sephiroth74/esp32-rc-telemetry/ROADMAP.md

# Firmware roadmap — step by step

The phase summary lives in [PLAN-ESP32.md](PLAN-ESP32.md) §8; this file breaks every phase into
steps. Section numbers (§) refer to PLAN-ESP32.md.

Every step is small, self-contained and testable, and none is done until:

- `make build` compiles and `make test` is green;
- a measurement it produced is in [docs/hardware.md](docs/hardware.md), and a decision it changed is
  in the plan.

**Order.** What has to be seen working first comes first: navigating the menu (Phase 2), then the
card and GNSS checks of the power-on self-test (Phase 3). Everything after builds on those two.

**Input hardware.** The steps assume the **two-button interim layout** of §3.1 — OK and NAV on the
D0 ladder. Fitting the JS5208 five-way switch is a separate procedure, possible at any point after
step 2.3: see [Switching to the JS5208](#switching-to-the-js5208).

`[x]` done · `[ ]` to do.

## Phase 0 — Bench tools (done)

- [x] **0.1 Display, card and button.** `tools/oled-sd-test`: OLED at 0x3C, SDMMC 1-bit at 40 MHz,
  FAT32 and long names, a 256 KB speed test, a restart button, a GPS page.
- [x] **0.2 GNSS link.** `tools/gps-test` on the shared `tools/lib/gm10`: GM10 found at 115200,
  NMEA and UBX, MON-VER answered.
- [x] **0.3 Results recorded.** Bench session 1 in `docs/hardware.md`.

## Phase 1 — Hardware bring-up and pin-map freeze

- [x] **1.1 Two-button ladder.** Fit the external 10 kΩ pull-up on D0, keep OK straight to GND, and
  add NAV through 10 kΩ. A small sketch, `tools/keys-test`, prints the ADC reading in mV for every
  key and shows the classified key on the OLED.
  *Done when:* the readings for OK, NAV and no key are in `docs/hardware.md`, and `KEY_MV_BOUNDS` in
  `config.h` is derived from them.
  *Result:* OK 0 mV, NAV 1,623 mV, no key 3,120 mV — the ADC saturates there — with no phantom
  presses; the RIGHT/none bound moved to 2,695 mV.
- [x] **1.2 Which GPIO is DAT3** (§2.2). Hold the candidate GPIO low while calling
  `SD_MMC.begin()`. A card that sees DAT3 low at CMD0 enters SPI mode, so the SD-mode init fails:
  failing with GPIO21 low means DAT3 is 21, failing with GPIO3 low means it is 3.
  *Done when:* the answer is in `docs/hardware.md`, and `PIN_SD_D3` and `PIN_RC_THROTTLE` are final
  in `pins.h` — throttle moves to D1 if DAT3 is GPIO3.
  *Result:* **GPIO21**, with `tools/sd-dat3-test`: one candidate low per power-up, since a card
  picks its mode once and ignores DAT3 after that. GPIO3 low mounted, GPIO21 low failed. Throttle
  stays on D2, and D1 stays spare.
- [ ] **1.3 GM10 supply** (§9 question 16). Check the module's input range. If it accepts 3.3 V,
  power it from 3V3 and repeat the `tools/gps-test` link check.
  *Done when:* the answer is in `docs/hardware.md`, and §2.7 says which rail powers the GM10.
- [ ] **1.4 GM10 magnetometer** (§9 question 4, first half). If the module has SDA/SCL pads, first
  check that they idle at 3.3 V and not 5 V, then wire them to D4/D5 and read the I²C scan of
  `tools/oled-sd-test`. The config-flash half needs VALSET: step 4.1.
  *Done when:* answered in `docs/hardware.md`.
- [x] **1.5 What the receiver sends** (§2.5). `tools/rc-scope` reads one channel's signal wire on D3
  through a 10 kΩ/10 kΩ divider, with the ADC as a scope, and plots it in the Arduino IDE's Serial
  Plotter: width, period and level per frame, or the waveform. Only the signal and ground are wired;
  the XIAO runs from USB.
  *Done when:* the logic level, the frame period and the steering and throttle widths of each car on
  the bench are in the per-car table of `docs/hardware.md`, inside the `RC_*` windows of `config.h`
  or with those windows changed.
  *Result:* the Inferno's KR-331 — 3.3 V logic, positive pulses every 16.6 ms (60 Hz), steering
  1,050–1,500–1,940 µs, throttle 1,005–1,500–≈1,940 µs, no telemetry on the throttle wire: all inside
  the `RC_*` windows, which stay as they are. Repeat for each new car.
- [x] **1.6 Freeze the pin map.**
  *Done when:* `pins.h` holds no `UNRESOLVED`, and the wiring section of `docs/hardware.md` describes
  the bench build.
  *Result:* DAT3 was the last open pin (step 1.2). The bench build and the car are KiCad schematics
  in `hardware/`, with the nets of `pins.h`, checked by the ERC and net by net.

## Phase 2 — Keys, display and menu navigation (first priority)

Goal: every screen of §3.4 reached and left with the two buttons, on placeholder data. The logic
lives in `lib/ui`, free of `Arduino.h` and host-tested (§6.1); `src/` only adapts the hardware.

- [x] **2.1 Key windows.** `lib/ui`: classify a reading in mV as OK, UP, DOWN, LEFT, RIGHT or no
  key against `KEY_MV_BOUNDS`. A key counts after `KEY_CONFIRM_SAMPLES` equal readings; a reading
  outside every window is discarded.
  *Test:* host tests on synthetic sample streams — clean presses, bounces, two keys at once.
- [x] **2.2 Gestures and layouts.** `lib/ui`: turn the key stream into events — short, long (firing
  at 1.5 s, with the hold-bar progress from 300 ms), auto-repeat for UP/DOWN — and apply the
  two-button mapping: NAV short is DOWN, NAV held 1 s is LEFT. This mapping is the only
  layout-specific code.
  *Test:* host tests for each layout, at the edges of every threshold (799/800 ms, 1499/1500 ms).
  *Result:* `lib/ui/ui_keys.{h,cpp}`, fed from `config.h` through `include/key_config.h`; 20 host tests
  in `test/test_ui`, against the measured ladder levels, including the millisecond counter wrapping.
- [x] **2.3 Keys on the device.** `src/keys.cpp`: ADC1_CH0, read in one-shot mode with the
  calibration curve so the result is in mV, at 100 Hz in the `ui` task. The events of 2.2 go to a
  queue.
  *Test:* on the bench, every press logged on the serial console as the right event.
  *Result:* `src/keys.cpp` and the `ui` task (`src/ui_fsm.cpp`), with `analogReadMilliVolts()` —
  the call the levels were measured with. On the bench every gesture gave its event at the exact
  threshold: NAV back at 1,000 ms, OK hold at 1,500 ms while still held, nothing for OK released at
  1,380 ms; readings OK 0 mV, NAV 1,613–1,628 mV, no key 3,121 mV.
- [x] **2.4 Display driver.** `src/display.cpp`: U8g2 on the hardware I²C at 400 kHz behind the bus
  mutex. Primitives for the status bar, the six body lines, the toast and the hold bar. Only dirty
  pages are sent (`updateDisplayArea`), at most at 5 Hz.
  *Test:* a test screen on the bench. Time a full-frame and a one-page update and record both in
  `docs/hardware.md`: they check the bus budget of §2.4.
  *Result:* `src/display.cpp` and the bus lock `src/i2c_bus.cpp`. Full frame 31.3 ms, one page
  3.9 ms — a little above the plan's estimate, same conclusion. On the bench the toast, the hold
  bar and the 80 ms inversion behave as §3.1–§3.2 say. A missing display is skipped in the code
  (headless boot), but that path is first tested in step 3.2.
- [x] **2.5 Menu model.** `lib/ui`: the menu tree of §3.4 as data — Home, Menu, submenus, dialogs
  (hold OK = yes, any other key or 10 s = no), list and value editors — with the cursor,
  wrap-around, back, and the 30 s fall-back to Home.
  *Test:* host tests that walk paths: Home → OK → Menu → … → Settings › Display → change → OK;
  dialogs answered both ways; both timeouts.
  *Result:* `lib/ui/ui_menu.{h,cpp}` — the lists as data, editors opening on the value in force, the
  refusals of §3.4 (no card, no fix, logging refused, no RC signal), and the two confirmation
  dialogs reachable from the menu. What an entry does comes out as a `Command` for the caller; the
  facts go in through `MenuContext`. 21 host tests in `test/test_menu`.
- [x] **2.6 Screens on placeholder data.** Render every screen of §3.4 from the model, with fixed
  sample data for GNSS, card, track and laps. SESSION, GEOMETRY, CALIBRATION and TRANSFER are stub
  states, entered and left as §3.7 says.
  *Test:* on the bench, every screen reached and left with the two buttons; every text within 21
  columns; the key hints in the two-button wording.
  *Result:* `lib/ui/ui_board` (the modes, their dialogs and toasts) and `lib/ui/ui_screens` (a pure
  render), with 16 host tests in `test/test_board` — one renders every screen and mode in both
  layouts and both text sizes and proves each line fits. On the bench the 5x8 text proved too small:
  `tools/font-test` compared seven fonts, the **6x13B** won, and text size became a setting of its
  own, small or large, with large the default and content that scrolls (§3.2).
- [x] **2.7 The on-device settings, for real.** Display brightness, dim delay and text size applied to
  the panel; the car profile selection stored. Kept in NVS for now — they move into `config.json` in
  step 3.6.
  *Test:* all of them survive a reset.
  *Result:* `src/settings` keeps brightness, dim delay, text size, the profile count and the active
  profile in NVS, checked against their ranges when read back, and writes only what a command
  changed. Brightness is the SSD1306 contrast (16, 96, 255), dimmed is 0. On the bench, low, 15 s,
  small and a New car came back after a reset as `settings: brightness low, dim after 15 s, text
  small, profile 4 of 4`. The bench also asked for the press that brightens a dimmed display to do
  nothing else: `Gestures::swallow()` now drops what the gesture has queued too, host-tested, and
  checked on the bench with OK, OK held and NAV on a dimmed display.
- [x] **2.8 New car and New track** (§3.4, §3.8, §7.1). New car is the choice after the profiles in
  Settings › Car profile; New track an entry of Track, held to create. Both work for any car or
  track that was not set up from a computer, and the apps rename them.
  *Result:* in `lib/ui` with their refusals — no card, no fix, `Full: 8 profiles` — and New car
  landing on Calibrate. Every screen is now tested with the longest track id, `N4512E00934-99`, which
  moved the start-line dialog onto new lines. The placeholder facts carry both out on the bench.

- [x] **2.9 Restart from the menu** (§3.4). Settings › Restart, held: the toast, then a restart and
  the POST. Asked on the bench in place of a key gesture, which the ladder cannot make safe.
  *Result:* works on the bench.

*Phase done when:* a walk through all of §3.4 on the bench, with the two buttons only.

## Phase 3 — Power-on self-test: card and GNSS link (first priority)

- [x] **3.1 POST runner.** The ordered checks of §3.3, one line per check on the POST screen, the
  result bitmask, the fatal latch with the hold-OK retry, the 3 s list of degraded checks, then
  IDLE. The keys are dead throughout. Ordering and severity logic in `lib/ui`.
  *Test:* host tests with fake checks — pass, degraded, fatal, fatal then passing on retry.
  *Result:* `lib/ui/ui_post` — the eleven checks with their severities, the run, the latch and its
  retry, the list worst first, the bitmask and the summary for About — and `renderPost` for its
  screens; 11 host tests in `test/test_post`, every screen within 21 columns at both sizes. On the
  device `src/post` runs it from `setup()` before the ui task, and swallows a key still held at the
  end. Check 0 is the display; the others report `--` until their steps. It reaches Home in 0.8 s.
- [x] **3.2 Checks 0–2.**
  - Display: I²C bus recovery, address ACK, init. A missing display boots headless.
  - PSRAM: the 256 KB ring buffer allocated.
  - LittleFS: mounted with the `littlefs` label (§6.3).

  *Test:* on the bench, with the display unplugged the board still boots, and the serial console
  shows the result.
  *Result:* `i2cBusBegin()` clocks a held SDA free before Wire starts, `log_ring` takes the 256 KB in
  PSRAM once, and LittleFS mounts by its `littlefs` label, formatting a blank partition on the first
  boot. On the bench: `0 Display ok`, `1 PSRAM ok 8MB`, `2 Config ok 8K used`, Home at 0.8 s; with
  the display unplugged, `POST fail 0`, Home at 3.0 s after the list, and the keys still acted.
- [x] **3.3 Checks 3–6, the card.**
  - Mount: SDMMC 1-bit at 40 MHz, with DAT3 held high.
  - Free space: against `sd.min_free_mb` and `sd.warn_free_mb`.
  - Probe: 256 KB written, read back, compared and deleted, timed to give the card speed.

  The logic is the one proven in `tools/oled-sd-test` (`mountSd`, `testSpeed`).
  *Test, on the bench:*
  - no card → fatal 3; insert it and hold OK → passes;
  - exFAT card → fatal 3, naming the cause;
  - nearly full card → degraded 4, logging refused;
  - normal card → its speeds in the result.

  *Result:* `src/card` mounts at 40 MHz with DAT3 high, and when the mount fails asks the card
  itself why — no answer, or a first sector showing exFAT, GPT or no FAT32. On the bench: no card →
  `3 Card FAIL no card`, the latch, the card back in and OK held → `3 Card ok 58GB`, `4 Free ok
  58.2GB`, `5 Write ok`, `6 Speed ok 3276KB/s`. A card left in SPI mode by the DAT3 test was refused
  the same way until unplugged. Not tried for want of the cards: an exFAT or GPT card, and a nearly
  full one, whose thresholds the host tests cover.
- [x] **3.4 UBX frame scanner.**
  1. Capture raw GM10 traffic into `docs/fixtures/`, with a raw-dump mode in `tools/gps-test`
     that writes the UART bytes to the card.
  2. Write `lib/ubx`: frame sync, length, Fletcher checksum, the raw frame out (§5.4).

  *Test:* host tests against the captured fixtures, including truncated and corrupted frames.
  *Result:* the raw dump of `tools/gps-test` (`d`) prints six seconds of the UART as hex while
  polling NAV-PVT, NAV-SAT and MON-VER; the module, as delivered, sends NMEA and NAV-PVT at 10 Hz.
  The first 1,691 bytes are `docs/fixtures/gm10-indoor-115200.hex`. `lib/ubx`'s scanner returns
  frames whole and unchanged, and after a failed one searches again from the next byte, so a false
  sync or a cut frame costs nothing after it; 10 host tests in `test/test_ubx`. The bench had the
  GPS's TX and RX swapped, which reads as no data at any baud (`docs/hardware.md`).
- [x] **3.5 Check 8, the GNSS link.** The auto-baud scan of §5.2: 230400, 115200, 38400 and 9600
  baud, looking for `0xB5 0x62` or `$G` within 1.5 s per rate. It runs as POST check 8.
  *Test, on the bench:* the link is found at 115200, as the module was delivered. With the GPS
  unplugged: degraded 8, logging refused, Transfer still reachable.
  *Result:* `src/gnss_link` scans with `ubx::LinkProbe`, which takes a whole checksummed frame, UBX
  or NMEA, as the evidence, and tries the rate found last first; 4 host tests, noise included. On the
  bench: `8 GNSS ok 115200 bd` and Home in 1.2 s; with the GM10's 5 V off, `8 GNSS FAIL no reply`
  after the 6 s scan, Home at 10 s, a session start refused with `Logging refused: 8`, Transfer
  entered and left. The bench also showed Transfer could only be left with NAV held: OK leaves it
  now, as it leaves every screen that only informs.
  The bench then asked for more than a toast. A refusal is a notice now, on the whole body until a
  key; Home opens on the reason logging is refused, under a `No logging` status line; and what reads
  the card, needs the GNSS module or writes is refused up front (PLAN-ESP32.md §3.4, "What needs
  what"). Checked with the GM10 off: `No logging` at boot, the notice held 13 s until a key, which
  closed it and did nothing else, Track › Info and the start line refused with `no GNSS`.
- [x] **3.6 Results and settings.**
  - `/post.log` written on LittleFS.
  - Settings › About shows the result by check number.
  - `/config.json` read from the card, validated key by key and mirrored to LittleFS (§3.8, check 2).
  - The settings of step 2.7 move into `config.json`.

  *Test:* a `config.json` with a bad key → that key falls back to its default and is listed in
  `/post.log`. With the card removed, the LittleFS copy is used.
  *Result:* `/post.log` holds the POST line by line with the reasons, and the source of the
  settings; About lists the eleven checks. `lib/cfg` reads `config.json` key by key against the
  defaults of `config.h` (8 host tests); check 2 loads the LittleFS copy and check 3 the card's,
  which wins and is mirrored. The first boot moved step 2.7's NVS settings into a new file on the
  card. On the bench, edited on a Mac: `"brightness": "bright"` → `config: card, 1 key at the
  default: display.brightness`, the rest of the file in force; a file that is not JSON → `card
  unread`, the LittleFS copy used and the file left alone; the file deleted → `config: created`,
  written back from the LittleFS copy with the settings unchanged. The card cannot be missing at
  this point — check 3 is fatal — so "card removed" became "card's file unreadable".

*Phase done when:* the board boots through the POST on the bench, and every card and GNSS failure
ends on the screen §3.3 describes.
*Done,* on the bench, for every failure there was a way to cause: no card, a card left in SPI mode,
no GNSS module, a config.json wrong or unreadable. An exFAT, a GPT and a nearly full card remain to
try when one is at hand; their logic is host-tested.

## Phase 4 — GNSS

- [x] **4.1 Configuration.** UBX-CFG-VALSET for:
  - NAV-PVT at 10 Hz and NAV-SAT at 1 Hz;
  - NMEA off;
  - 230400 baud;
  - SBAS on;
  - `DYNMODEL` 4.

  It is applied to RAM+BBR and must be acknowledged: that is POST check 9, retried in the
  background. Also try the FLASH layer, and record whether the module accepts it (§9 question 4).
  *Result:* `gnss_config.cpp`, on VALSET, VALGET and the ACKs of `lib/ubx/config_db` (7 host tests).
  Check 9 reads the RAM layer back and writes only what differs, so a module already set is left
  alone (`as set`), then reads the BBR and FLASH layers back into `/post.log`. On the GM10 as Flywoo
  delivered it, the first boot changed four keys — NAV-SAT on, NMEA off, `DYNMODEL` 4, 230400 baud —
  and the module has config flash: it took the VALSET to FLASH and holds all eleven keys there, so it
  now comes up set without its BBR. The BBR itself outlived 15 s unpowered. That first boot's log
  was lost, since TinyUSB drops what is printed before a host opens the port; the firmware now
  echoes `/post.log` each time a host opens it. Not seen on the bench yet: a module that does not
  answer (the background retry) and one at the u-blox defaults, 9600 baud with NMEA only.
- [x] **4.2 NAV-PVT and NAV-SAT decode** in `lib/ubx`.
  *Test:* host tests against fixtures captured after 4.1.
  *So far:* `lib/ubx/nav`: NAV-PVT whole, all 92 bytes, and NAV-SAT read in place a satellite at a
  time, with `fix3d()` for the fix §3.4 trusts. Tested against the indoor capture (four epochs at
  10 Hz, no fix, an empty sky) and against frames built at the documented offsets for a fix and for
  three satellites.
  *Result:* `docs/fixtures/gm10-fix-230400.hex`, a second of the configured stream at a window:
  nine fixes at 10 Hz, 10 satellites used of the 24 NAV-SAT lists, its position moved onto the sample
  point. Two more host tests read it against a Python decode of the same bytes (29 in `test_ubx`).
- [x] **4.3 GNSS task.** Core 1, a 2048 B UART receive buffer, a raw-frame queue of 32, loss
  counters (§4.2, §5.3).
  *So far:* `gnss_task.cpp`, built, not yet run. Reads with a 20 ms block, scans, and decodes NAV-PVT
  and NAV-SAT into a live state any task can copy; whole frames with a receive timestamp go into a
  queue of 32 in PSRAM, only while the logger asks for them, so IDLE costs no false loss. Counts UART
  overruns and errors, bad checksums, lengths out of range and a full queue. Takes check 9's retry
  over from `loop()`. A console line every 10 s gives the rate, the fix and the losses, for the
  bench: 100 epochs in 10 s, 0 lost, is what to see.
  *Result:* on the bench, 100 epochs in every 10 s for over half an hour, indoors and at a window,
  0 lost.
- [x] **4.4 Live GNSS on screen.** The GNSS screen and the status bar fed by real NAV-PVT: the link
  and its baud, the fix and satellites, the coordinates, hAcc and pDOP (§3.4). Measure the time to
  first fix, cold and warm, into `docs/hardware.md`.
  *So far:* `lib/ui/ui_gnss`: the acquisition of §3.4 — `Acquiring`, `Fix` after 3 s within 5 m,
  `Timeout` at 90 s, a new acquisition when the fix is lost (7 host tests). The ui task feeds it the
  gnss task's epochs and fills the facts from the live state: the link while the module keeps
  sending, the fix, `used/seen` satellites, coordinates, hAcc, pDOP and speed while the epoch is
  fresh, the loss count into the warning mark, and the gating's fix. Holding OK on the GNSS screen
  restarts the clock. The sample GNSS values are gone.
  *Result:* at a window, `Fix 3D, 10/15 sats`, hAcc 0.75 m, pDOP 3.5. First fix cold, after two days
  unpowered: 141 s from the hold, about 255 s from power-on; hot, after 16 s unplugged: 5 s from
  power-on. Both in `docs/hardware.md`.

## Phase 5 — Logging core and manual sessions

- [x] **5.1 Record format.** The `.rcl` records written down in `docs/protocol.md` before any code
  (§7.2).
  *Result:* a 24-byte file header with a per-session nonce, then records of sync, type, length,
  session time in ms, payload and a CRC-32 seeded with the nonce: a power cut's tail of zeros or of
  an older session is skipped, never misread. Eight types — session header, UBX frame (whole and
  verbatim), IMU aggregate, IMU raw, RC samples, marker, lap, footer — with RC and IMU batched per
  100 ms epoch, about 2.5 KB/s in all. Payloads grow only by appending fields.
- [x] **5.2 Packing.** `lib/rcl`, with host tests and golden fixtures shared with `rct_core`.
  *Result:* `lib/rcl` writes the file header and whole records with their CRC, reads a file record by
  record, and encodes and decodes each payload type. The golden file is `rcl-golden-v1`: values in
  JSON, bytes in hex, the bytes written by a Python script from `docs/protocol.md` alone, and
  `lib/rcl` agrees with it both ways. 11 host tests, the golden ones included, then a cut at every
  byte, tails of zeros and of an older session, a corrupted record and a mangled length, headers
  that are not ours, and payloads that grow. `rct_core` is held to the same two files when it comes.
  One rule changed in `docs/protocol.md` on the way: a length running past the end no longer ends
  the reading, since a length mangled mid-file would have cost every record after it.
- [x] **5.3 Logger task** (§4.4): the PSRAM ring buffer, 32 KB writes, pre-allocated 4 MB extents,
  a flush every 5 s, latency statistics.
  *So far:* `lib/logbuf`, host-tested (8 tests): the ring of whole records — in entire or dropped
  and counted, out in order however the writer slices it, across the wrap and through a stall that
  fills it — and the write statistics of the footer: the longest, the 99th percentile from a fixed
  histogram, the writes over 250 ms. The design changed on the way (§4.2): producers append records
  to the ring themselves and the logger only writes it out, so the gnss task's frame queue of 4.3
  goes once the logger is on the device.
  *Then:* `src/logger.cpp` on the device, the gnss task's queue gone. First session on the bench
  (2026-10-22, 51 s, no fix): the first 4 MB extent in 5 ms, 11 writes of at most 8 ms, nothing
  dropped, the file cut to its 76,720 bytes. Read back on a Mac by a Python reader written from
  `docs/protocol.md`: 570 records, every CRC good, 0 bytes skipped, 514 NAV-PVT a step of 100 ms
  each, the two markers, the footer matching `meta.json`.
  *Result:* the half hour of 5.5 (2026-10-24, bench session 3 in `docs/hardware.md`): 32 min 55 s,
  21,726 records, nothing dropped. 426 writes, the longest 13 ms and the 99th percentile 7 ms, none
  slow, and at most 6,700 bytes waiting in the ring of 256 KB.
- [ ] **5.4 On-card layout** (§7.1): track cell id and resolution, session numbering, `meta.json`.
  A track whose geo-fence contains the fix comes first, then the 300 m radius; among several the one
  used most recently wins, and Track › New track creates a folder at the fix with the next suffix.
  The point-in-polygon test lives in `lib/geo`, host-tested; the GNSS screen names the track.
  *So far:* the rules written down in `docs/algorithms.md` and implemented in `lib/geo`, host-tested
  (13 tests): the cell id in integers, truncated; the distance; the fence test, exact in integers;
  which track a fix belongs to; a new track's name with the first free suffix; the session numbers,
  widening past 999. One rule made explicit on the way (§7.1): a fenced track is recognised by its
  fence only, so a fix at the unfenced club next door is not taken for it. Still to do, on the
  device: reading `track.json`, the folders, `meta.json`, and the GNSS screen's track.
  *Then:* `src/session.cpp`: track resolution on the card one `track.json` at a time, a new track's
  folder and `track.json`, `session_NNN`, the global id from NVS, `meta.json` at the start and the
  footer's numbers at the end, and the move out of `_unassigned` when a fix comes. The clock is set
  from the first fully resolved NAV-PVT, so files carry real dates and `meta.json` its UTC start.
  Seen on the bench so far: `_unassigned/session_001` and its `meta.json`.
  *Then:* at a window (2026-10-24, bench session 2 in `docs/hardware.md`), three sessions begun
  without a fix. The first made its track at the close, `N4732E00851`, and moved into it. The
  second, whose hAcc never reached 5 m, stayed in `_unassigned`. The third moved into the same track
  as its `session_002`, recognised by the radius. Every log was whole, with nothing lost. All times
  on the card are UTC, and `start.utc` of a session begun before the clock is derived at its close
  (§7.1, decided on the way).
  *Then:* the screens name the card's track. `sessionLookup()` in `src/session.cpp` reads where a
  session started now would be filed: the track, its name from the apps, start line, geometry, how
  many sessions and the next number; `_unassigned` without a fix. The ui task runs it in IDLE when
  the fix comes or goes, after moving 50 m, and after any session or command. Without a track the
  screens say why: `none, no fix`, `none, no card`, or `new here`, which the next session makes
  (184 host tests). On the device, indoors with no fix: `none, no fix` on Home, the GNSS screen and
  the Session entry, and `Next: session_005`, the next in `_unassigned`.
  *Then:* Track › New track makes its folder at the fix, with the next free suffix, and Track ›
  Choose lists the tracks within reach of the fix, for where two compete (§7.1, decided
  2026-10-24); either makes its track the resolved one while the fix stays within reach, until
  another is chosen or the device restarts (188 host tests). Still to do, at a window: the screens
  with a fix, a session begun **on** the fix and filed at its start, New track and Choose.
- [ ] **5.5 Manual sessions** (§3.6): hold OK to start, hold OK and confirm to stop; markers; the
  session screen's GNSS page live.
  *Test:* a 30-minute bench session with clean latency and loss numbers.
  *So far:* the half hour, held by hand on the bench (2026-10-24): every record whole, NAV-PVT a
  step of 100 ms each from the first to the last, 0 UART errors, 0 lost in any of the 224 windows of
  10 s the console reported. The figures are 5.3's. After the stop the screens read the card again:
  `_unassigned`, 5 sessions, next 6. The session's GNSS page then read as the GNSS screen does:
  satellites used and seen, and `hAcc --` without a fix where it had shown the module's unknown as
  `655.35 m` (185 host tests). Still to do: a look at that page on the device, where the satellites
  seen move even indoors.
  Decided on the way (§3.6, 2026-10-24): **a session needs the fix**, by hand or automatically —
  the GNSS screen's `Fix`, not a bare 3D. Without it Home reads `Acquiring` and a hold brings
  `No GNSS fix yet`; the automatic start says so once and starts when the fix comes.
  `session.require_fix: false` in `config.json` lifts it for the bench (186 host tests).
  Settings › Require fix sets it on the device, written to both copies of `config.json` as the
  display settings are; its value shows in the Settings list. On the device: `on` brought
  `Acquiring` and the refusal at once, and held across a restart (197 host tests).

## Phase 6 — RC inputs, car profiles, automatic sessions, sleep

- [ ] **6.1 RC front end.** Per input, 10 kΩ in series, a BAT43 clamp to 3V3 and a 100 kΩ pull-down
  (§2.5; the 74LVC2G17 first planned gave way to through-hole parts). For each car, the logic
  level and the BEC voltage go into `docs/hardware.md`.
- [x] **6.2 RC capture.** MCPWM capture with pulse validation and reject counters; RC samples in the
  log; POST check 10 (§4.3).
  `tools/rc-live` already times one channel this way on the bench, with the `RC_*` windows, and
  shows it on the OLED as a bar from the centre.
  *So far:* `src/rc_capture.cpp`: both inputs on one capture timer, each pulse checked against
  its width and frame windows, rejects counted per input, an input present once a pulse passes.
  A 50 Hz sampler logs RC records, five to an epoch, while a session is open; the footer takes the
  session's rejects and `meta.json` the inputs present. POST check 10 names them. The screens show
  the live widths, the session's inputs page in µs until a calibration (191 host tests). On the
  bench (bench session 5): steering 1,054–1,936 µs, throttle 1,002–1,956 µs, 60 Hz with none
  missed, `steer+thr` at boot.
  *Result:* a 48 s bench session read back over USB: 483 RC records, one every 100 ms, five
  samples each; steering 1,054–1,943 µs and throttle 1,003–1,957 µs, never 0; 0 rejects in the
  footer, both inputs present in `meta.json`.
- [x] **6.3 Car profiles and calibration** (§3.8, §4.3).
  - Profiles read from `config.json` and chosen in Settings › Car profile.
  - New car: a `Car N` profile appended to both copies of `config.json`, the NVS calibration at its
    index cleared, the profile made active.
  - The Calibrate procedure, with its overwrite confirmation.
  - One calibration per profile in NVS, copied into each session's `meta.json`.

  *So far:* `lib/rc`, host-tested (10 tests) on the bench car's widths: endpoints by meaning, the
  percentage on each side's own scale, rounded and held at ±100, the check of a capture before it is
  saved and the reason the summary gives for refusing one, the accepted window, and the six steps
  filling a calibration, an absent input's axis left uncaptured. `src/calibration.cpp` keeps one
  calibration a profile in NVS, loads the active profile's at boot and on a change of profile,
  clears it for New car, and gives each calibrated input its own accepted window; `meta.json` takes
  the endpoints. The session's inputs page turns to percentages, `--` with no pulse (195 host
  tests).
  *Result*, with the car away, on the `sim` build (`firmware/include/bench_sim.h`): bench session
  5's widths sent through the inputs' windows from the console, and the keys pressed from it. The
  six steps gave `St 1054 1500 1936`, `Th 1002 1498 1956`; held OK saved them for Car 4, and
  Calibrate read `Calibrated: yes`, after a restart too. On the inputs page: full lock and full
  throttle ±100 %, 1,727 µs on the steering +52 % and 1,250 µs on the throttle −50 %, `--` with the
  receiver off. Steering at 2,100 µs, outside its window of 954–2,036 µs, was all rejects, from
  boot. A session's `meta.json` carried the endpoints. The next time the car is on the bench, its
  own calibration replaces the simulated one.
- [ ] **6.4 Automatic start and stop** (§3.6). The rules are host-tested in `lib/ui`.
  *So far:* `lib/ui/ui_auto` decides from speed and throttle, each counted only when known, and the
  board acts on it: from IDLE only and with `session.auto_start` on, through Home with any dialog
  closed, a refusal shown once, the stop after `session.auto_stop_min` still with a stop dialog
  closed, and no new run after a stop by hand until the car has stood still for 5 s (12 host tests,
  §3.6 refined). The ui task feeds it the GNSS speed, and the throttle as a percentage once the
  profile's throttle is calibrated (step 6.3): on the `sim` build, the throttle held at full brake
  started a session 1 s after the calibration was saved.
  *Test:* on the bench with the throttle, then on track with speed. Record the thresholds against §9
  question 17.
- [ ] **6.5 Power off and sleep** (§4.5). There is no backup battery (§2.7, decided 2026-10-25):
  the car switched off is the device switched off, and a session is ended by hand first.
  - A session the switch cut, closed at the next boot.
  - Sleep from IDLE, for a device powered otherwise than by the car; a USB host keeps it awake.
  - Wake on OK.

  *Test:* switch the car off mid-session → at the next boot the file is cut after its last record,
  parseable, and `meta.json` reads `close: unclosed`.

  *So far:* `sessionBegin()` names the open session in NVS and `sessionEnd()` clears it; at boot
  `sessionRecover()` cuts the `.rcl` after its last whole record, found by `rcl::findTail()` in
  128 KB pieces (4 host tests), and gives `meta.json` `close: unclosed`, a line in `/post.log`. The
  board sleeps from IDLE only (`lib/ui/ui_power.h`, 9 host tests, 210 in all): the RC signal
  stopping, or 5 min with no RC signal, no host and no key, give a 10 s notice that any key, the
  pulses or a host cancel; a session is never ended by the pulses. `src/power.cpp` switches the
  display off, unmounts the card and sleeps until OK. The status bar's LiPo mark is gone.
  On the bench, on the `sim` build (`reset` restarts at once, `usb off` hides the host, a 20 s
  timer stands in for OK): a session reset 8.5 s in was closed at the next boot in 170 ms, 106
  records and 8,052 of 4,194,304 bytes kept, 0 bytes skipped on reading, its first 5.0 s;
  `meta.json` read `close: unclosed`. In IDLE the notice counted down from 10 s, OK cancelled it and
  opened nothing, and left alone it slept; 5 min after the last activity it came by itself; each
  sleep woke into the POST, `woken by timer`.
  Still to do: the wake on OK, with a finger on the button; and the switch-off in the car.
- [ ] **6.6 Aux channel trigger** on D1, if §2.2 left it free (§8, deferred).

## Phase 7 — IMU

- [ ] **7.1 LSM6DSO32**, optional (§2.6), read through its FIFO and sharing the bus with the display
  under the mutex.
  POST check 7; per-epoch aggregates in the log. Decide on the raw stream (§9 question 7).

## Phase 8 — Track and laps

- [ ] **8.1 Gate crossing.** `docs/algorithms.md` written first; then `lib/geo` gate crossing, with
  host tests on a recorded lap — including a recorded off and a recorded cut (§7.5).
  *So far:* "Laps" in `docs/algorithms.md`: the epochs that count, the local plane, the gate, the
  crossing — forwards, within 1000 ms, within the width, interpolated to the ms, 5 s apart — and a
  lap's distance. `lib/geo/laps.h` implements it, `test_laps` holds it to
  `docs/fixtures/laps-v1.json`, a simulated session whose laps `make_laps.py` works out a third
  time from the document, and to each rule on its own. Still to do: a
  recorded session in place of the simulated one, and the device's side (8.4, 8.5).
- [ ] **8.2 The automatic start line.** The first lap found without a line, the gate at its fastest
  point, saved with source `auto`, and the session's laps worked out again from it (§7.5).
  Decided on the way (2026-10-25): **not on the first lap, but on two consecutive laps that agree**,
  as many laps as it takes when the first ones do not — the lap out of the pits, a run off the
  track, a cut — and at the car's fastest point in those two.
  *So far:* the rules in `docs/algorithms.md` — the first loop's closure among the moving epochs, a
  provisional gate there that cuts the trace into laps, two laps that agree (the shorter at least
  90 % of the longer, 95 % of each within 10 m of the other's path), the fastest point on the
  speed averaged over ±500 ms, the gate 15 m wide — and `geo::LineFinder`, which keeps the trace
  in a buffer of the caller's for the laps to be found again. On the fixture the first laps
  disagree, off then cut, and the gate comes with provisional laps 3 and 4, 2 min in; each rule
  has a test that fails without it (15 tests in `test_laps`, 225 in all). On the device with
  step 8.5: the trace in PSRAM, the line saved with source `auto`, the laps found again. Still to
  do: a real track.
- [ ] **8.3 Lap flags.** `cut` and `off` against the median lap distance; flagged laps never become
  the best lap.
  *So far:* `geo::medianM()` and `geo::flagOf()`, on the fixture's laps: a run off the track and two
  laps doubled by a missed line come out `off`, a cut `cut`. On the device (step 8.5) the Lap
  record keeps the flags its lap has when it ends, and the best is worked out again over the laps
  not flagged as the median moves. Still to do: a real track.
- [ ] **8.4 Track entries.** Track › Start line, with its overwrite confirmation; Track › Geometry;
  both showing their source, and the source rules of §7.5 when files arrive from the desktop app.
  Decided on the way (2026-10-26): the line is recorded **on the move**, holding OK while crossing
  it the way the race goes at 1 m/s or more; still, `Not moving`, as the module's heading at a
  standstill is a guess.
  *So far:* `start_line.json` holds the gate — position, heading, width, source
  (`firmware/include/session.h`) — and a line from elsewhere without a source counts as the
  desktop app's. Track › Start line and Home show the source; the hold and the overwrite's yes
  are refused still (226 host tests); the device writes the line with source `device`, a track
  made first where there is none. An automatic line never replaces one already there. Still to do:
  the recording on a real track, Track › Geometry.
- [ ] **8.5 Live laps and sectors.** The session's laps page, and the last and best laps on Home.
  *So far:* every NAV-PVT reaches the ui task through a queue of its own (`gnss_task.h`), and
  `src/lap_timer.cpp` times the session's laps with `lib/geo`: the track's line, or the search for
  one over a 10-minute trace in PSRAM, the line then saved for the track and the laps so far found
  again. Each crossing is a Lap record in the log with the flags its lap has then; the session's
  page and Home show the count, the last, the best of the laps not flagged and the delta, and a
  lap completed is a toast. On the bench, on the `sim` build with `drive on` — a car lapping a
  250 m stadium: no line, the search found it after two laps that agreed, `Line found, 2 laps`,
  then a lap every ~24 s; the log held the 7 Lap records, the first three written when the line
  came with their crossings in the past. Comparing two laps first took ~2 s of the ui task, the
  doubles being software's on the S3; with the comparison searching outwards and stopping early,
  30 ms, the answers the same. Still to do: a real track, and sectors.

## Phase 9 — Transfer

- [x] **9.1 USB MSC** from Menu › Transfer. Leaving it while a host is attached needs a confirmation
  (§7.3).
  *Result:* `src/transfer.cpp` and the raw sector access of `src/card.cpp`. The disk is part of the
  composite USB device from boot, with no medium until TRANSFER; entering unmounts SD_MMC and hands
  the card's sectors to the host, leaving takes the medium away and mounts the card again. A host
  that ejected the disk is let go without a confirmation (§7.3, refined); a card that does not
  answer ends TRANSFER with a notice (189 host tests). On the bench (2026-10-24, bench session 4 in
  `docs/hardware.md`), against macOS: the disk mounted, read, ejected and left, and the
  confirmation when leaving without the eject. A later Transfer left the disk without its medium
  on the Mac; the device now leaves the bus and comes back on entering, and the disk mounts.
- [ ] **9.2 BLE GATT**, only in TRANSFER: status, control and download per `docs/protocol.md`
  (§7.4), verified against the phone and desktop apps.

## Phase 10 — Field hardening

- [ ] **10.1 Soak test across a race day.** Review write latency and losses, and the JS5208's
  durability (§9 question 18).

## Phase 11 — Camera (optional)

- [ ] **11.1 Photos, then short clips**, on markers and laps, under the rules of §8, "Phase 11".

## Switching to the JS5208

Possible at any point after step 2.3.

1. Fit the switch on its carrier board: common to GND, OK to D0, and UP, DOWN, LEFT and RIGHT
   through 2.2k, 4.7k, 10k and 22k. NAV's 10k resistor stays, as LEFT's.
2. Measure each key with `tools/keys-test`; update `KEY_MV_BOUNDS` and `docs/hardware.md`.
3. Set `"keys": { "layout": "five" }` in `/config.json`. Nothing else changes: the mapping of step
   2.2 is the only code that knows which layout is fitted.
