sephiroth74/esp32-rc-telemetry/hardware/bench.pdf

1 | 2 | 3 | 4 | 5 | 6
1 | 2 | 3 | 4 | 5 | 6

AB

C

D

AB

C

D Date: 2026-10-19

Size: A4 | Rev: 1
KiCad E.D.A. 10.0.1 | Id: 1/1

## Title: Bench build: XIAO, display, two keys, GNSS, receiver taps

File: bench.kicad_sch

Sheet: /

esp32-rc-telemetry

Pin map: PLAN-ESP32.md 2.1. Measurements: docs/hardware.md. The car: car.kicad_sch.

RC inputs on the bench: 10 k in series, for receivers measured at 3.3 V logic only.

As wired on 2026-10-19. Powered from USB-C; the receiver's + rail is not connected. GND

S

1 +

2 -

3 M1

Steering servo +3V3R1

10k | +5V | +3V3 | GND
CH1/S 1 | CH2/S 2 | CH3/S 3 | +

4 -

5 U3 Kyosho KR-331 receiver D0/GPIO1 1 D1/GPIO2 2 D2/GPIO3 3 D3/GPIO4 4 D4/GPIO5/SDA 5 D5/GPIO6/SCL 6 D6/GPIO43/TX 7 D7/GPIO44/RX 8 D8/GPIO7/SCK 9 D9/GPIO8/MISO 10 D10/GPIO9/MOSI 11 3V3 12 GND 13 5V 14 BAT+ 15 BAT- 16 U1

Seeed XIAO ESP32-S3 Sense | GND
GND | +5V R3
10k | 5V 1 GND

2

# TX 3 RX 4 U2

Flywoo GOKU GM10 Nano (u-blox M10) R4

10k SW2 NAV SW1 OK

PWR_FLAG GND

GND

PWR_FLAG | GND

## 1 VCC

2

SCL | 3
SDA | 4 DS1 OLED 0.96in SSD1306 0x3C +5V | +3V3 | GND

GND

GND

S

1 BEC+

2 -

3 U4

ESC with BEC (Brainz 8) R2

10k | CH1_STEER

RC_STEER
SDA SCL D6_to_GPS_RX | RX_RAIL | CH1_STEER
GPS_TX_to_D7 | RX_RAIL D6_to_GPS_RX GPS_TX_to_D7 CH2_THROTTLE RC_STEER | CH1_STEER
RC_THROTTLE KEYS RC_THROTTLE SCL SDA KEYS | CH2_THROTTLE RX_RAIL | CH2_THROTTLE

GNSS: the module's TX to D7, the XIAO's RX; its RX to D6, the XIAO's TX. Swapped, the link shows no byte at any baud rate. 5 V from the 5V pad (3V3: ROADMAP.md step 1.3).

Keys: the two-button interim ladder (PLAN-ESP32.md 3.1): OK 0 V, NAV 1.62 V, none 3.12 V. Receiver taps: 10 k in series, enough for the KR-331's 3.3 V logic (tools/rc-scope). Unknown receiver: tools/rc-scope first, with 10 k from D3 to GND as a divider. CH1 by

unplugging the servo or with a Y-cable; CH2 needs a Y-cable, the ESC powering the

receiver through it. The receiver's + rail stays off the XIAO, which runs from USB. XIAO pads, USB-C up, from the top: left D0 D1 D2 D3 D4 D5 D6, right 5V GND 3V3 D10 D9 D8 D7; BAT+ and BAT- on the back. The microSD of the Sense board takes D8 CLK, D9 DAT0, D10 CMD and GPIO21 for DAT3, inside: leave D8-D10 free. D1 is spare, for the optional aux channel. | U1
Seeed XIAO ESP32-S3 Sense D0/GPIO1 1 | D1/GPIO2 2 | D2/GPIO3 3 | D3/GPIO4 4 | D4/GPIO5/SDA 5 | D5/GPIO6/SCL 6 | D6/GPIO43/TX 7 | D7/GPIO44/RX | 8 D8/GPIO7/SCK | 9 D9/GPIO8/MISO | 10 D10/GPIO9/MOSI | 11 3V3 12 GND 13 | 5V 14 | BAT+ 15 BAT- 16 GND

DS1 OLED 0.96in SSD1306 0x3C GND

## 1 VCC

2

SCL | 3
SDA | 4 GND | U2
Flywoo GOKU GM10 Nano (u-blox M10) 5V 1 GND

2

TX 3 | RX 4 | GND U3 Kyosho KR-331 receiver CH1/S 1 | CH2/S 2 | CH3/S 3 | +

4 -

5 GND U4

ESC with BEC (Brainz 8) S

1 BEC+

2 -

# 3 GND M1

Steering servoS

1 +

2 -

# 3 GND
