sephiroth74/esp32-rc-telemetry/hardware/perfboard-car.png

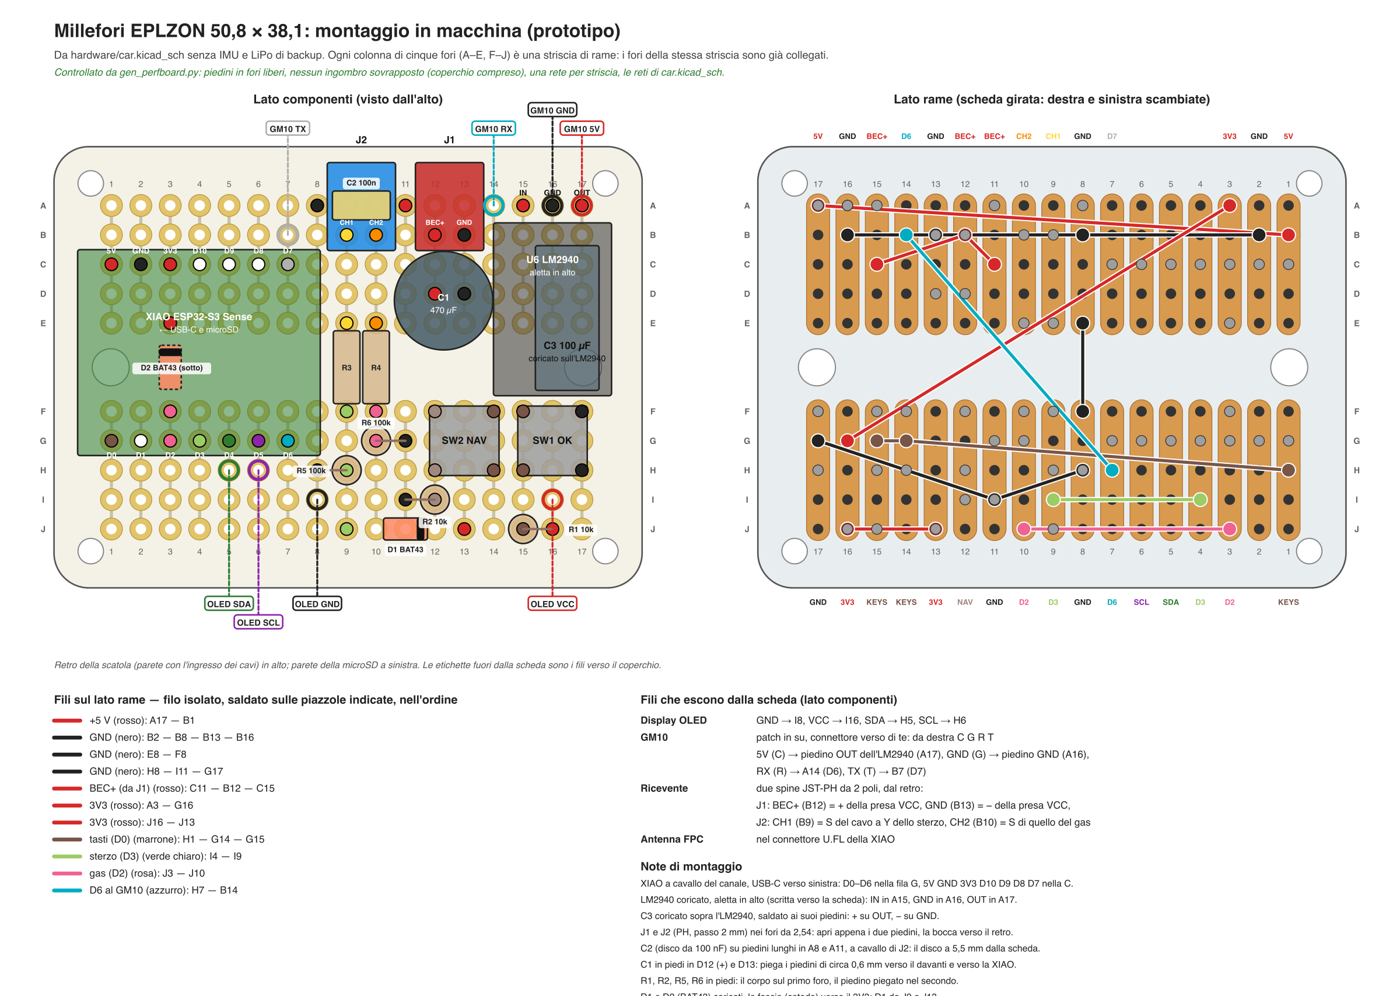
hardware/perfboard-car.png
