sephiroth74/esp32-rc-telemetry/hardware/stl/ribaltina.stl

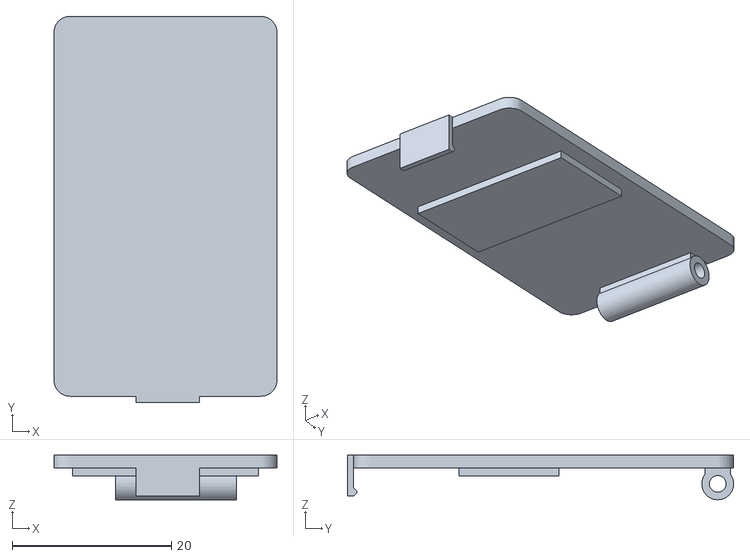
[picture p4: CAD file, 2026-10-27]
hardware/stl/ribaltina.stl
28.0 x 48.5 x 5.60
