sephiroth74/esp32-rc-telemetry/hardware/stl/fermo-gm10.stl

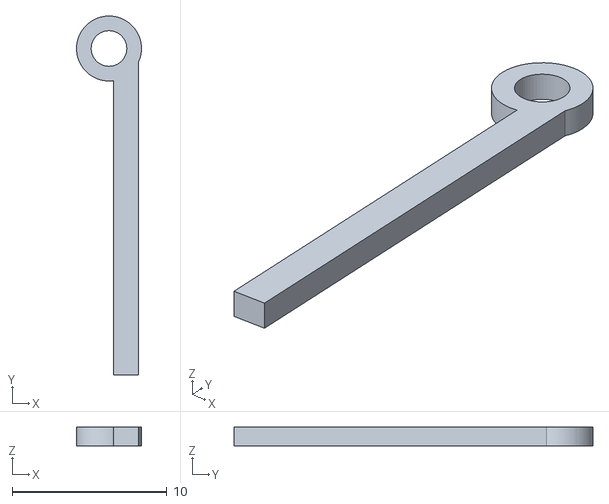
[picture p5: CAD file, 2026-10-27]
hardware/stl/fermo-gm10.stl
4.20 x 23.2 x 1.20
