sephiroth74/esp32-rc-telemetry/hardware/stl/piastra.stl

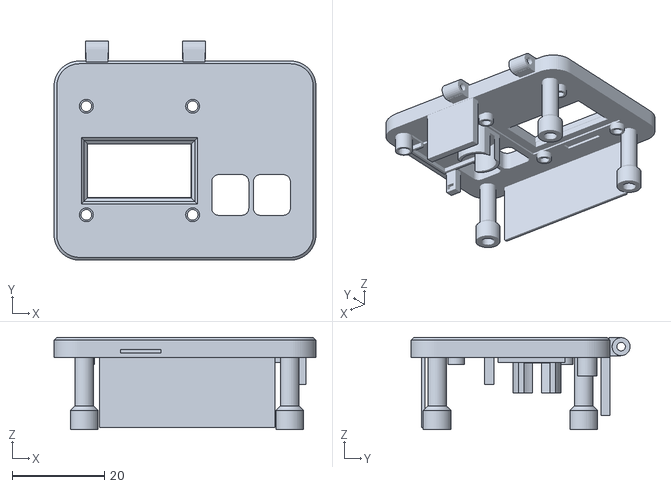
[picture p6: CAD file, 2026-10-27]
hardware/stl/piastra.stl
56.7 x 47.4 x 19.9
