sephiroth74/esp32-rc-telemetry/hardware/stl/tasto-ok.stl

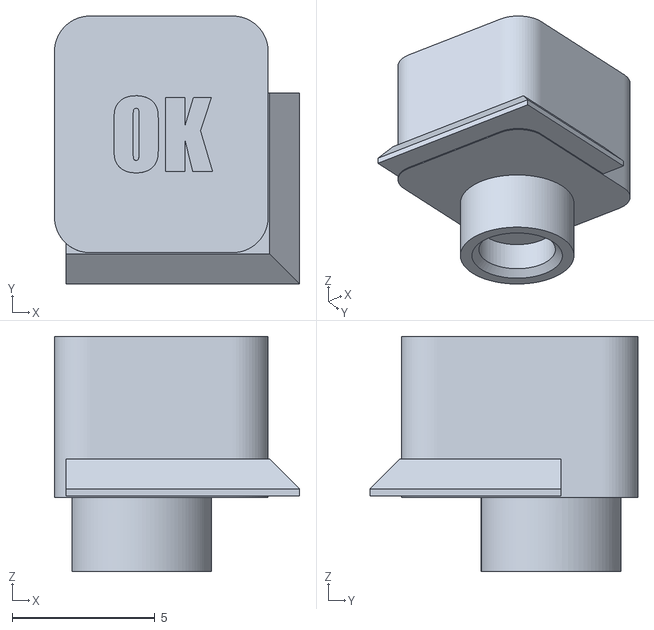
[picture p8: CAD file, 2026-10-26]
hardware/stl/tasto-ok.stl
8.60 x 9.40 x 8.25
