sephiroth74/esp32-rc-telemetry/hardware/stl/sportellino.stl

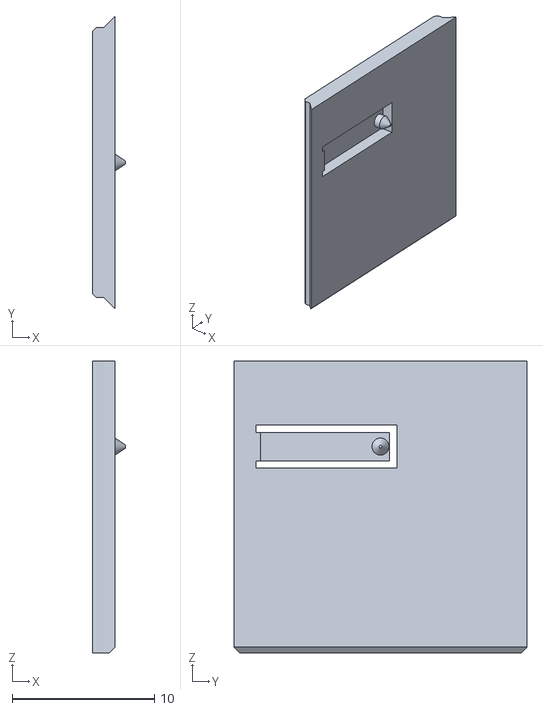
[picture p9: CAD file, 2026-10-26]
hardware/stl/sportellino.stl
2.35 x 20.6 x 20.5
