sephiroth74/esp32-rc-telemetry/hardware/stl/vasca.stl

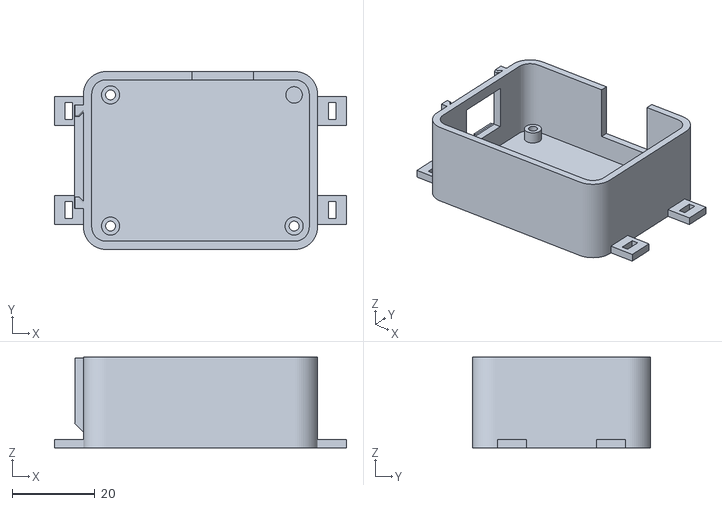
[picture p10: CAD file, 2026-10-26]
hardware/stl/vasca.stl
70.7 x 43.1 x 22.0
