sephiroth74/esp32-rc-telemetry/hardware/stl/stelo-nav.stl

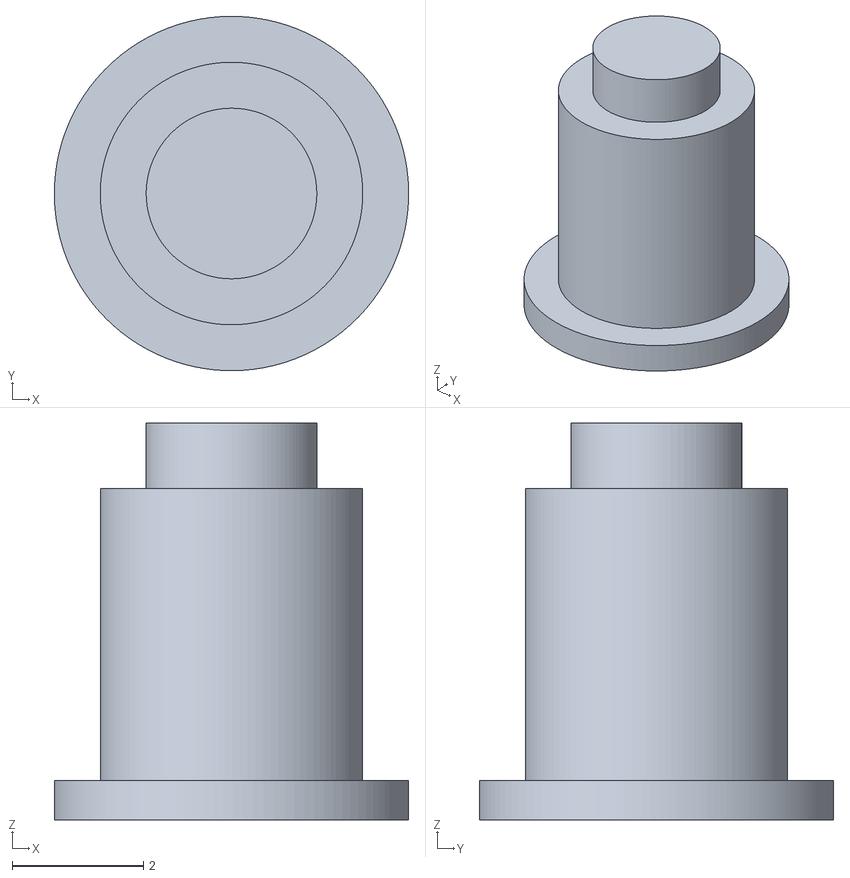
[picture p11: CAD file, 2026-10-26]
hardware/stl/stelo-nav.stl
5.40 x 5.40 x 6.05
