sephiroth74/esp32-rc-telemetry/(list of files, cad)

Other CAD files:
hardware/stl/stelo-ok.stl
