sephiroth74/esp32-rc-telemetry/hardware/assembly/img/02-piastra-sotto-raw.jpg

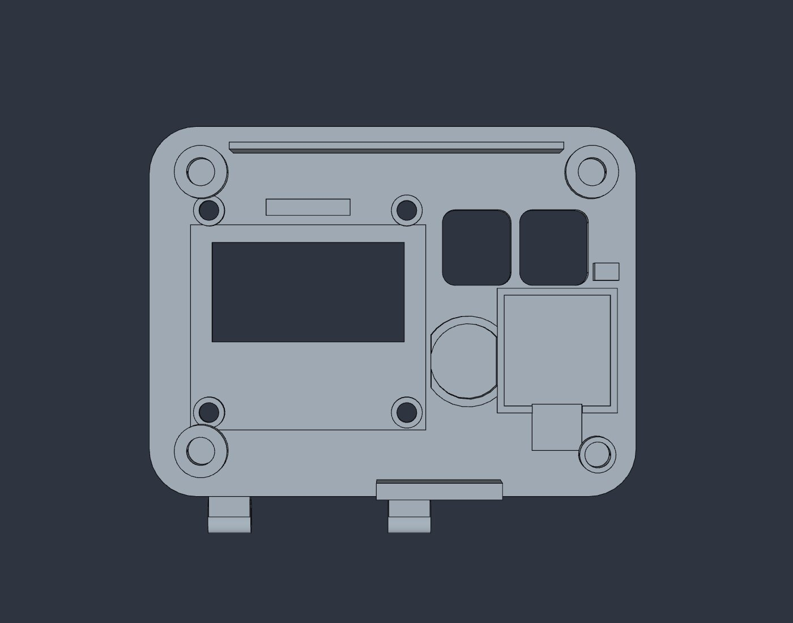
hardware/assembly/img/02-piastra-sotto-raw.jpg
