sephiroth74/esp32-rc-telemetry/hardware/assembly/img/04-piastra-mappa-raw.jpg

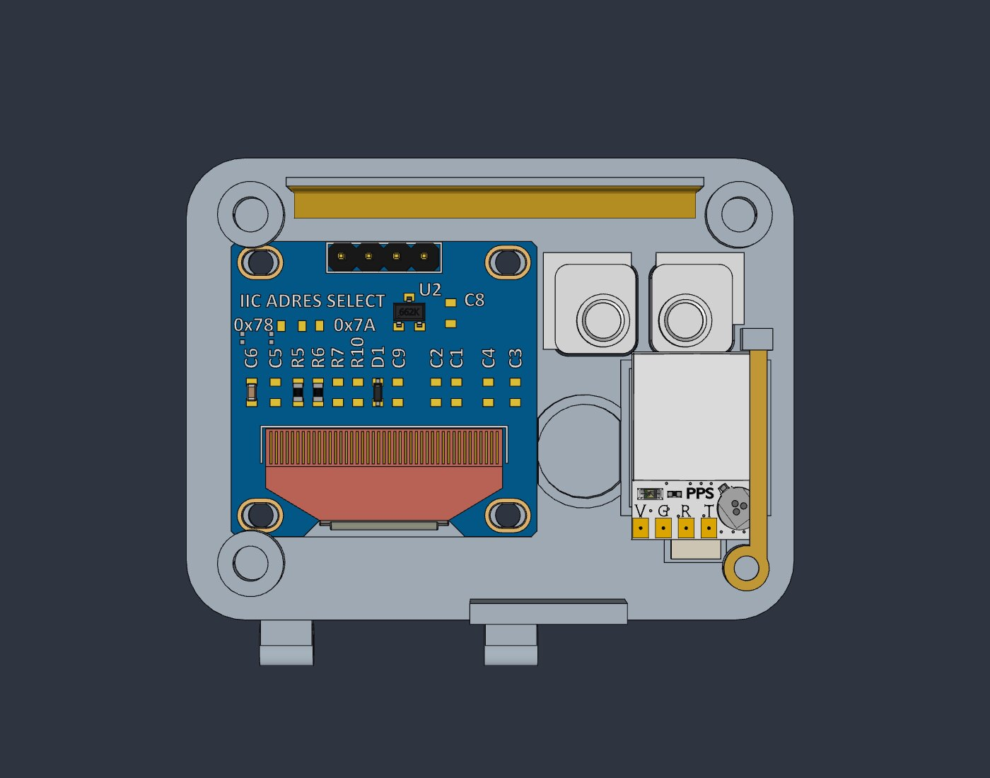
hardware/assembly/img/04-piastra-mappa-raw.jpg
