sephiroth74/esp32-rc-telemetry/hardware/wiring-bench.png

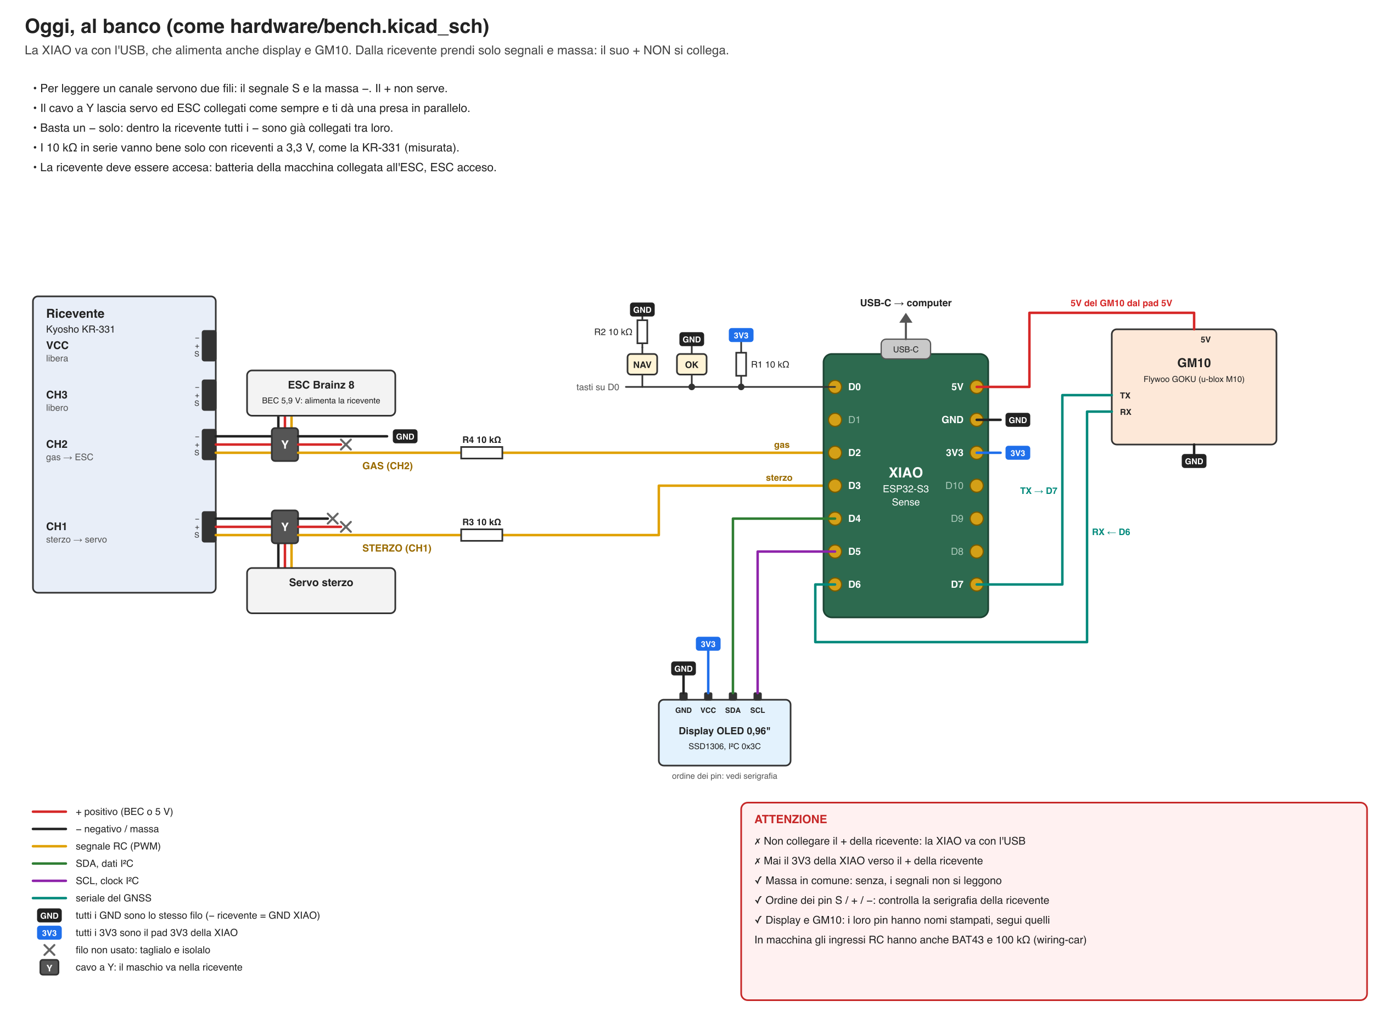
hardware/wiring-bench.png
