sephiroth74/esp32-rc-telemetry/hardware/wiring-car.png

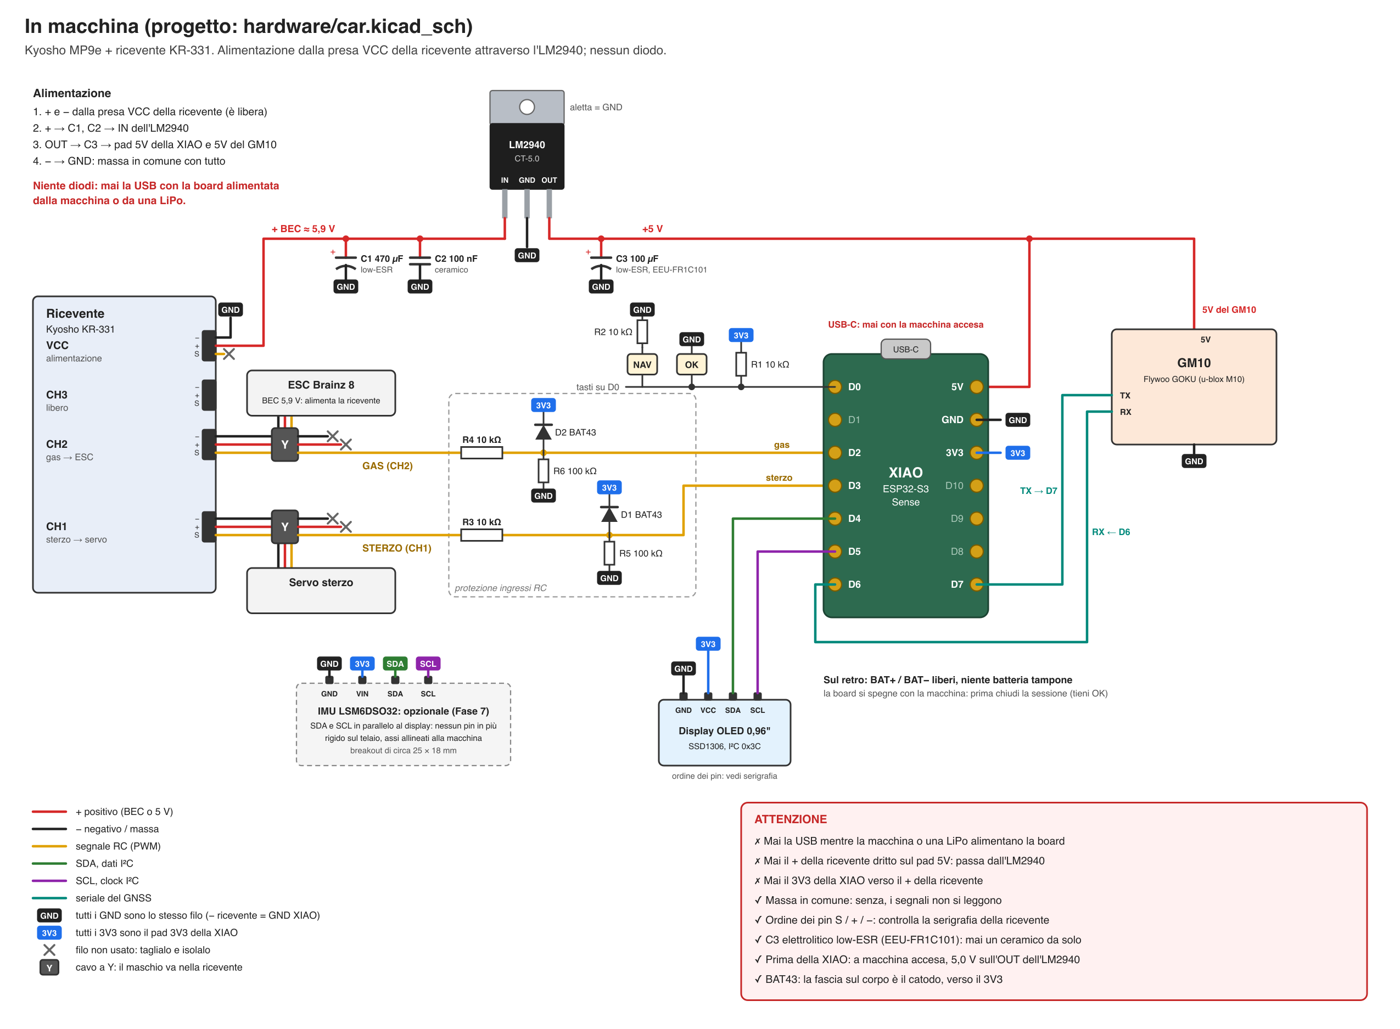
hardware/wiring-car.png
