sephiroth74/esp32-rc-telemetry/hardware/wiring-power-ldo.png

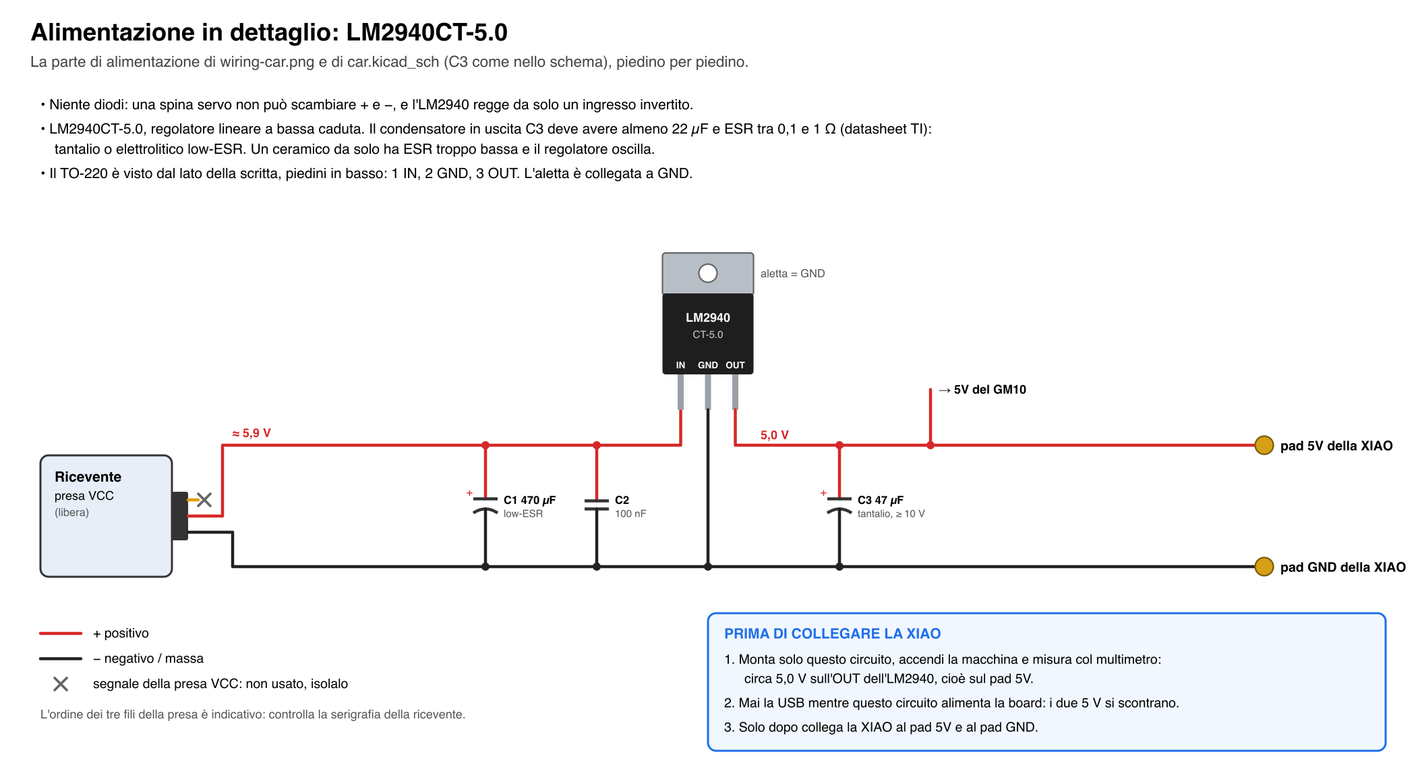
hardware/wiring-power-ldo.png
