sephiroth74/esp32-rc-telemetry/hardware/bench.kicad_sch

## KiCad design hardware/bench.kicad_sch (2026-10-26)

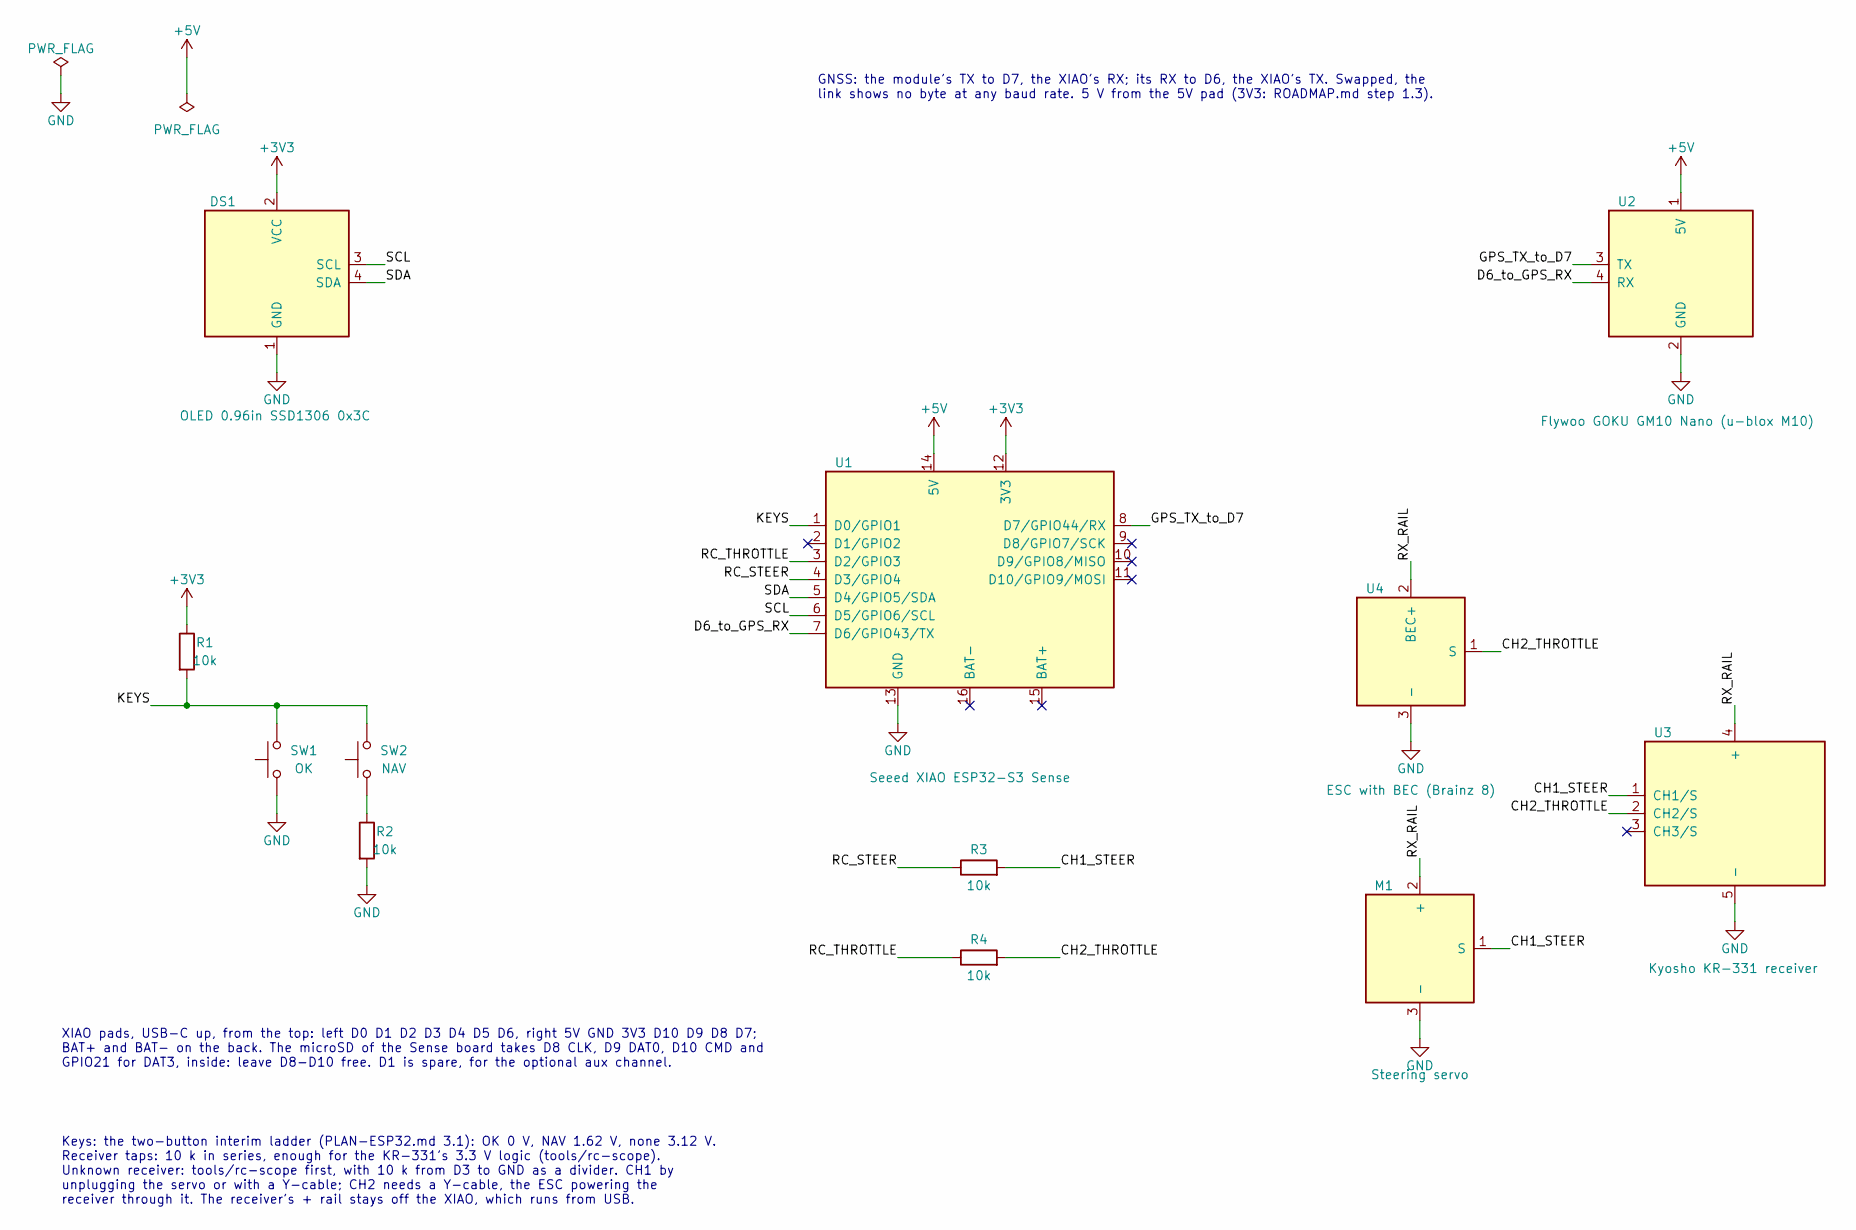
[picture p41: schematic bench.kicad_sch]

Parts:
DS1: OLED 0.96in SSD1306 0x3C
M1: Steering servo
R1, R2, R3, R4: 10k
SW1: OK
SW2: NAV
U1: Seeed XIAO ESP32-S3 Sense
U2: Flywoo GOKU GM10 Nano (u-blox M10)
U3: Kyosho KR-331 receiver
U4: ESC with BEC (Brainz 8)

Connections:
+3V3: DS1.2 (VCC), R1.1, U1.12 (3V3)
+5V: U1.14 (5V), U2.1 (5V)
CH1_STEER: M1.1 (S), R3.2, U3.1 (CH1/S)
CH2_THROTTLE: R4.2, U3.2 (CH2/S), U4.1 (S)
D6_to_GPS_RX: U1.7 (D6/GPIO43/TX), U2.4 (RX)
GND: DS1.1 (GND), M1.3 (-), R2.2, SW1.1, U1.13 (GND), U2.2 (GND), U3.5 (-), U4.3 (-)
GPS_TX_to_D7: U1.8 (D7/GPIO44/RX), U2.3 (TX)
KEYS: R1.2, SW1.2, SW2.2, U1.1 (D0/GPIO1)
unnamed: R2.1, SW2.1
RC_STEER: R3.1, U1.4 (D3/GPIO4)
RC_THROTTLE: R4.1, U1.3 (D2/GPIO3)
RX_RAIL: M1.2 (+), U3.4 (+), U4.2 (BEC+)
SCL: DS1.3 (SCL), U1.6 (D5/GPIO6/SCL)
SDA: DS1.4 (SDA), U1.5 (D4/GPIO5/SDA)

Notes on the sheet:
Keys: the two-button interim ladder (PLAN-ESP32.md 3.1): OK 0 V, NAV 1.62 V, none 3.12 V. Receiver taps: 10 k in series, enough for the KR-331's 3.3 V logic (tools/rc-scope). Unknown receiver: tools/rc-scope first, with 10 k from D3 to GND as a divider. CH1 by unplugging the servo or with a Y-cable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
GNSS: the module's TX to D7, the XIAO's RX; its RX to D6, the XIAO's TX. Swapped, the link shows no byte at any baud rate. 5 V from the 5V pad (3V3: ROADMAP.md step 1.3).
XIAO pads, USB-C up, from the top: left D0 D1 D2 D3 D4 D5 D6, right 5V GND 3V3 D10 D9 D8 D7; BAT+ and BAT- on the back. The microSD of the Sense board takes D8 CLK, D9 DAT0, D10 CMD and GPIO21 for DAT3, inside: leave D8-D10 free. D1 is spare, for the optional aux channel.
