sephiroth74/esp32-rc-telemetry/hardware/car.kicad_sch

## KiCad design hardware/car.kicad_sch (2026-10-25)

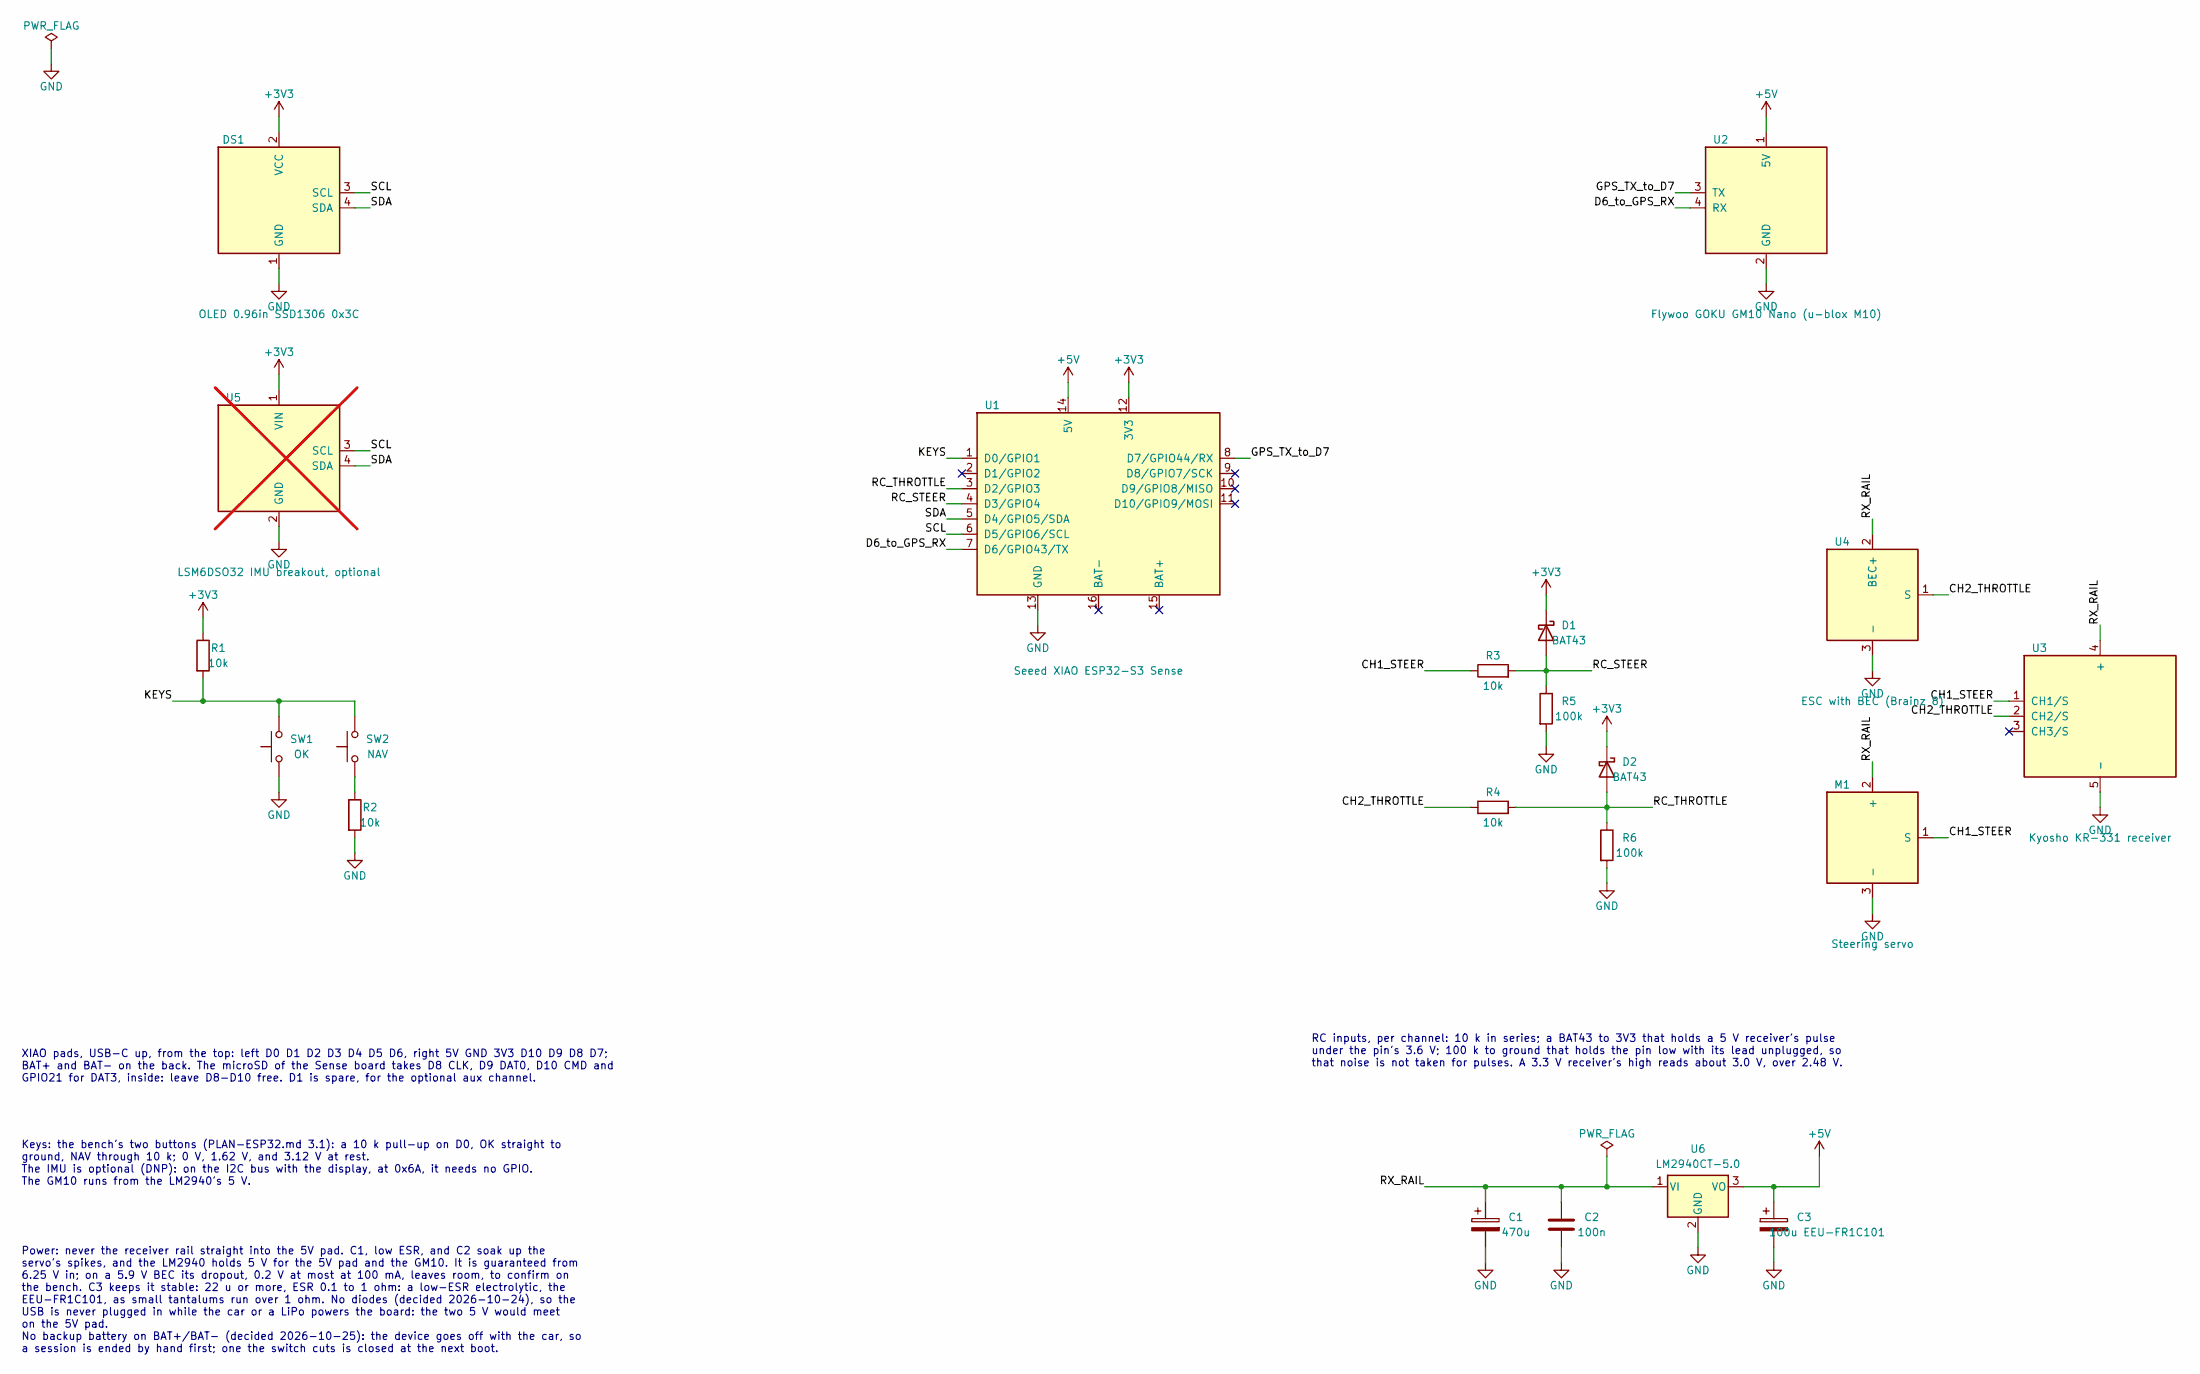
[picture p42: schematic car.kicad_sch]

Parts:
C1: 470u
C2: 100n
C3: 100u EEU-FR1C101
D1, D2: BAT43
DS1: OLED 0.96in SSD1306 0x3C
M1: Steering servo
R1, R2, R3, R4: 10k
R5, R6: 100k
SW1: OK
SW2: NAV
U1: Seeed XIAO ESP32-S3 Sense
U2: Flywoo GOKU GM10 Nano (u-blox M10)
U3: Kyosho KR-331 receiver
U4: ESC with BEC (Brainz 8)
U5: LSM6DSO32 IMU breakout, optional; not fitted
U6: LM2940CT-5.0

Connections:
+3V3: D1.1 (K), D2.1 (K), DS1.2 (VCC), R1.1, U1.12 (3V3), U5.1 (VIN)
+5V: C3.1, U1.14 (5V), U2.1 (5V), U6.3 (VO)
CH1_STEER: M1.1 (S), R3.1, U3.1 (CH1/S)
CH2_THROTTLE: R4.1, U3.2 (CH2/S), U4.1 (S)
D6_to_GPS_RX: U1.7 (D6/GPIO43/TX), U2.4 (RX)
GND: C1.2, C2.2, C3.2, DS1.1 (GND), M1.3 (-), R2.2, R5.2, R6.2, SW1.1, U1.13 (GND), U2.2 (GND), U3.5 (-), U4.3 (-), U5.2 (GND), U6.2 (GND)
GPS_TX_to_D7: U1.8 (D7/GPIO44/RX), U2.3 (TX)
KEYS: R1.2, SW1.2, SW2.2, U1.1 (D0/GPIO1)
unnamed: R2.1, SW2.1
RC_STEER: D1.2 (A), R3.2, R5.1, U1.4 (D3/GPIO4)
RC_THROTTLE: D2.2 (A), R4.2, R6.1, U1.3 (D2/GPIO3)
RX_RAIL: C1.1, C2.1, M1.2 (+), U3.4 (+), U4.2 (BEC+), U6.1 (VI)
SCL: DS1.3 (SCL), U1.6 (D5/GPIO6/SCL), U5.3 (SCL)
SDA: DS1.4 (SDA), U1.5 (D4/GPIO5/SDA), U5.4 (SDA)

Notes on the sheet:
XIAO pads, USB-C up, from the top: left D0 D1 D2 D3 D4 D5 D6, right 5V GND 3V3 D10 D9 D8 D7; BAT+ and BAT- on the back. The microSD of the Sense board takes D8 CLK, D9 DAT0, D10 CMD and GPIO21 for DAT3, inside: leave D8-D10 free. D1 is spare, for the optional aux channel.
Keys: the bench's two buttons (PLAN-ESP32.md 3.1): a 10 k pull-up on D0, OK straight to ground, NAV through 10 k; 0 V, 1.62 V, and 3.12 V at rest. The IMU is optional (DNP): on the I2C bus with the display, at 0x6A, it needs no GPIO. The GM10 runs from the LM2940's 5 V.
RC inputs, per channel: 10 k in series; a BAT43 to 3V3 that holds a 5 V receiver's pulse under the pin's 3.6 V; 100 k to ground that holds the pin low with its lead unplugged, so that noise is not taken for pulses. A 3.3 V receiver's high reads about 3.0 V, over 2.48 V.
Power: never the receiver rail straight into the 5V pad. C1, low ESR, and C2 soak up the servo's spikes, and the LM2940 holds 5 V for the 5V pad and the GM10. It is guaranteed from 6.25 V in; on a 5.9 V BEC its dropout, 0.2 V at most at 100 mA, leaves room, to confirm on the bench. C3 keeps it stab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
