sephiroth74/esp32-rc-telemetry/firmware/src/gnss_task.cpp

#include "gnss_task.h"

#include <Arduino.h>

#include <sys/time.h>
#include <time.h>

#include <atomic>

#include "config.h"
#include "gnss_config.h"
#include "gnss_link.h"
#include "logger.h"
#include "ui_fsm.h"

namespace {

constexpr uint32_t kStackBytes = 4096;

TaskHandle_t task = nullptr;

// The UART's own errors arrive on HardwareSerial's event task: counted there, read here.
std::atomic<uint32_t> uartOverruns{0}, uartErrors{0};

portMUX_TYPE liveLock = portMUX_INITIALIZER_UNLOCKED;
GnssLive live;  // under liveLock

constexpr UBaseType_t kEpochQueue = 32;  // 3.2 s at 10 Hz
QueueHandle_t epochs = nullptr;
std::atomic<uint32_t> epochsDropped{0};

void queueEpoch(const GnssEpoch& e) {
  if (!epochs) epochs = xQueueCreate(kEpochQueue, sizeof(GnssEpoch));
  if (epochs && xQueueSend(epochs, &e, 0) != pdTRUE) {
    epochsDropped.fetch_add(1, std::memory_order_relaxed);
  }
}

ubx::Scanner scanner;

void onUartError(hardwareSerial_error_t error) {
  if (error == UART_FIFO_OVF_ERROR || error == UART_BUFFER_FULL_ERROR) {
    uartOverruns.fetch_add(1, std::memory_order_relaxed);
  } else if (error != UART_NO_ERROR) {
    uartErrors.fetch_add(1, std::memory_order_relaxed);
  }
}

// The system clock from the first epoch whose date and time are valid and fully resolved: files on
// the card get real dates, and meta.json its UTC start. Once a boot; UTC, as the module gives it.
// TZ stays UTC0 for good: FatFs dates files with localtime(), and every time on the card is UTC
// (PLAN-ESP32.md §7.1). A time of day on the display is made local apart from it.
void setClock(const ubx::NavPvt& pvt) {
  static bool set = false;
  if (set || !pvt.validDate() || !pvt.validTime() || !(pvt.valid & 0x04)) return;
  struct tm t = {};
  t.tm_year = pvt.year - 1900;
  t.tm_mon = pvt.month - 1;
  t.tm_mday = pvt.day;
  t.tm_hour = pvt.hour;
  t.tm_min = pvt.minute;
  t.tm_sec = pvt.second;
  setenv("TZ", "UTC0", 1);
  tzset();
  timeval tv = {mktime(&t), 0};
  if (tv.tv_sec > 0 && settimeofday(&tv, nullptr) == 0) {
    set = true;
    Serial.printf("gnss: clock set, %04u-%02u-%02u %02u:%02u:%02u UTC\n", pvt.year, pvt.month,
                  pvt.day, pvt.hour, pvt.minute, pvt.second);
  }
}

void handle(const ubx::Frame& f, uint32_t nowMs) {
  logAppend(rcl::Type::Ubx, nowMs, f.bytes, f.size);  // nothing outside a session
  ubx::NavPvt pvt;
  ubx::NavSat sat;
  if (ubx::decodeNavPvt(f, pvt)) {
    setClock(pvt);
    taskENTER_CRITICAL(&liveLock);
    live.pvt = pvt;
    live.havePvt = true;
    live.pvtAtMs = nowMs;
    ++live.epochs;
    if (!live.firstFixMs && pvt.fix3d()) live.firstFixMs = nowMs;
    taskEXIT_CRITICAL(&liveLock);
#ifndef BENCH_SIM  // the bench's car is the simulation's, whatever the module says
    GnssEpoch e;
    e.atMs = nowMs;
    e.iTowMs = pvt.iTowMs;
    e.latE7 = pvt.latE7;
    e.lonE7 = pvt.lonE7;
    e.gSpeedMmS = pvt.gSpeedMmS;
    e.headMotE5 = pvt.headMotE5;
    e.fix3d = pvt.fix3d();
    queueEpoch(e);
#endif
  } else if (ubx::decodeNavSat(f, sat)) {
    uint8_t tracked = 0, used = 0;
    for (uint8_t i = 0; i < sat.numSvs; ++i) {
      ubx::NavSatSv sv = sat.sv(i);
      if (sv.cnoDbHz) ++tracked;
      if (sv.used()) ++used;
    }
    taskENTER_CRITICAL(&liveLock);
    live.haveSat = true;
    live.satsTracked = tracked;
    live.satsUsed = used;
    taskEXIT_CRITICAL(&liveLock);
  }
}

// Check 9 unanswered at the POST: tried again from here, between reads. The exchange reads the
// UART itself, so whatever this task's scanner held is stale afterwards.
void retryConfig(uint32_t& lastTryMs) {
  uint32_t now = millis();
  if (!gnssConfigPending() || now - lastTryMs < GNSS_CFG_RETRY_MS) return;
  lastTryMs = now;
  ui::CheckReport report = gnssConfigure();
  scanner.reset();
  Serial.printf("GNSS config retried: %s\n", report.detail);
  gnssConfigLog(Serial);
  uiPostUpdate(9, report);
}

// A line on the console every GNSS_BENCH_LOG_MS: the rate, the fix and the losses, for the bench.
void benchLog(uint32_t nowMs, uint32_t& lastMs, uint32_t& lastEpochs) {
  if (nowMs - lastMs < GNSS_BENCH_LOG_MS) return;
  GnssLive l;
  gnssLiveRead(l);
  Serial.printf("[%7lu] gnss: %lu epochs in %lu s, fix %u%s, %u sv used, %u seen, hAcc %lu mm, "
                "lost %lu\n",
                (unsigned long)nowMs, (unsigned long)(l.epochs - lastEpochs),
                (unsigned long)((nowMs - lastMs) / 1000), static_cast<unsigned>(l.pvt.fixType),
                l.pvt.fix3d() ? " ok" : "", l.pvt.numSv, l.satsTracked,
                (unsigned long)l.pvt.hAccMm, (unsigned long)l.loss.total());
  lastMs = nowMs;
  lastEpochs = l.epochs;
}

void gnssTask(void*) {
  HardwareSerial& port = gnssSerial();
  port.setTimeout(GNSS_READ_TIMEOUT_MS);
  uint8_t buf[256];
  uint32_t lastTryMs = millis(), lastLogMs = millis(), lastEpochs = 0;
  for (;;) {
    retryConfig(lastTryMs);
    // Back with a full buffer, or with what came within the timeout: about 11 ms of bytes at
    // 230400 baud, so a frame waits no longer than that.
    size_t n = port.readBytes(buf, sizeof buf);
    uint32_t nowMs = millis();
    for (size_t at = 0; at < n;) {
      at += scanner.push(buf + at, n - at);
      ubx::Frame f;
      while (scanner.next(f)) handle(f, nowMs);
    }
    const ubx::Stats& s = scanner.stats();
    taskENTER_CRITICAL(&liveLock);
    if (n) live.lastByteMs = nowMs;
    live.loss.uartOverruns = uartOverruns.load(std::memory_order_relaxed);
    live.loss.uartErrors = uartErrors.load(std::memory_order_relaxed);
    live.loss.badChecksum = s.badChecksum;
    live.loss.oversize = s.oversize;
    taskEXIT_CRITICAL(&liveLock);
    benchLog(nowMs, lastLogMs, lastEpochs);
  }
}

}  // namespace

void gnssTaskStart() {
  if (task || !gnssLinkBaud()) return;
  live = GnssLive();
  live.startMs = millis();
  gnssSerial().onReceiveError(onUartError);
  xTaskCreatePinnedToCore(gnssTask, "gnss", kStackBytes, nullptr, TASK_GNSS_PRIO, &task,
                          TASK_GNSS_CORE);
}

bool gnssTaskRunning() { return task != nullptr; }

void gnssLiveRead(GnssLive& out) {
  taskENTER_CRITICAL(&liveLock);
  out = live;
  taskEXIT_CRITICAL(&liveLock);
}

bool gnssNextEpoch(GnssEpoch& out) { return epochs && xQueueReceive(epochs, &out, 0) == pdTRUE; }

uint32_t gnssEpochsDropped() { return epochsDropped.load(std::memory_order_relaxed); }

#ifdef BENCH_SIM
void gnssInjectEpoch(const GnssEpoch& e) { queueEpoch(e); }
#endif
