sephiroth74/esp32-rc-telemetry/firmware/include/session.h

// A session's place on the card — PLAN-ESP32.md §7.1, ROADMAP.md steps 5.4 and 5.5.
//
// Starting one: the track the fix belongs to, by docs/algorithms.md's rules (lib/geo), among the
// folders of /tracks — or a new folder named from the cell, or /tracks/_unassigned without a fix;
// the next session_NNN in it; the global session id from NVS; meta.json; then the log (logger.h).
// Ending one: the log closed, meta.json completed with the footer's numbers, and a session that
// began without a fix moved into its track if a fix came before the end.
//
// track.json, as the device writes it and reads it back:
//
//   {"version": 1, "id": "N4512E00934", "name": "", "last_used": 42,
//    "centre": {"lat_e7": 451234560, "lon_e7": 93456780},
//    "fence": [[lat_e7, lon_e7], …]}
//
// "name" and "fence" are the apps'; the device leaves them as it found them. "last_used" is the
// global id of the last session filed there: it only grows, and needs no clock.
//
// start_line.json, when there is one (§7.5, docs/algorithms.md "The gate"):
//
//   {"version": 1, "lat_e7": 451234560, "lon_e7": 93456780, "heading_e5": 9000000,
//    "width_m": 15, "source": "auto"}
//
// "source" is "auto", "device" or "desktop"; a file without one is taken as the desktop app's, the
// best. Without "heading_e5" there is no gate to cross, though the position still helps recognise
// the track; without "width_m", 15 m.
#pragma once

#include <stdint.h>

#include "geo.h"
#include "laps.h"
#include "rcl.h"

struct SessionStart {
  bool haveFix = false;  // the acquisition's fix (§3.4), not a bare 3D
  geo::Point fix;
  bool automatic = false;
  uint8_t profile = 0;
  const char* profileName = "";
  uint16_t postMask = 0;
  const char* postSummary = "";
};

struct SessionInfo {
  uint32_t id = 0;      // global, from NVS: what the apps key on
  uint32_t number = 0;  // within its track
  char track[geo::kTrackIdMax + 1] = "";
  bool newTrack = false;
};

constexpr uint8_t kTrackChoicesMax = 6;

// Where a session started now would be filed, as the screens name it (§3.4): the track the fix
// belongs to, or none, which a session would make; without a fix, _unassigned. With a fix, also
// Track › Choose's list: every track within reach of it, the resolved one among them.
struct TrackView {
  bool found = false;  // a track on the card holds the fix
  char id[geo::kTrackIdMax + 1] = "";
  char name[33] = "";  // track.json's, given in the apps; empty until then
  bool hasStartLine = false;
  geo::LineSource lineSource = geo::LineSource::Auto;  // with hasStartLine
  bool hasGeometry = false;
  uint16_t sessions = 0;  // the session_NNN folders already there
  uint32_t next = 1;      // the number the next one takes
  uint8_t choices = 0;
  uint8_t resolved = 0;  // which of the choices is the track above
  char choiceIds[kTrackChoicesMax][geo::kTrackIdMax + 1] = {};
  char choiceNames[kTrackChoicesMax][15] = {};  // its name from the apps, cut to 14, else its id
};

// Read from the card, a few small files: for IDLE, with the card mounted and no session open.
void sessionLookup(bool haveFix, geo::Point fix, TrackView& out);

// Track › Choose (§7.1): this track is resolved in place of the rules while the fix is within its
// reach, until another is chosen or the device restarts.
void sessionChoose(const char* track);
// Track › New track (§7.1): a folder at the fix, the cell id with the next free suffix, chosen as
// above. False with a session open, or when the card takes no folder.
bool sessionNewTrack(geo::Point fix, char (&out)[geo::kTrackIdMax + 1]);

// False with nothing open: no card to write to, or a folder or a file that could not be made.
bool sessionBegin(const SessionStart& start, SessionInfo& out);
// `haveFix`/`fix`: what the acquisition has now, for a session that began without a fix.
void sessionEnd(rcl::Close reason, bool haveFix, geo::Point fix);
bool sessionOpen();
const SessionInfo& sessionCurrent();
// The open session's track's start line, when it has one with a heading.
bool sessionStartLine(geo::Gate& out);
// The automatic line (§7.5) into the open session's track: never over a line already there, and
// never into _unassigned, which is no track. False when it was not written.
bool sessionSaveAutoLine(const geo::Gate& gate);
// Track › Start line (§3.4): `gate`, source `device`, into `track`, over whatever is there — the
// menu asked first. From IDLE, with no session open.
bool sessionRecordStartLine(const char* track, const geo::Gate& gate);
// At boot, with the card mounted and before any session: one that the car switched off left open
// (§4.5), named in NVS by sessionBegin() until sessionEnd(), is cut after its last whole record,
// its meta.json given `close: unclosed`. A file that is not that session's is left alone.
void sessionRecover();
