sephiroth74/esp32-rc-telemetry/firmware/include/post.h

// The power-on self-test on the device — PLAN-ESP32.md §3.3, ROADMAP.md steps 3.1–3.5.
//
// Runs lib/ui's Post from setup(), before any task exists (§4.1): each check on the hardware, the
// POST screen on the display, and in the fatal latch the keys polled here directly. Returns once
// the device may enter IDLE, with a key that is still held swallowed, so that a press made during
// the POST does nothing afterwards either.
//
// So far checks 0–6 and 8 are real; the others report "--" until their steps bring them: 7 and 9 in
// phase 4, 10 in phase 6.
#pragma once

#include "ui_post.h"

ui::PostResult postRun();  // after i2cBusBegin() and keysBegin()
// /post.log back on the serial console: the POST's own lines can come before a USB host has opened
// the port, the file is there after. loop() calls it each time a host opens the port.
void postEchoLog();
// A line more in /post.log, for what the boot does after the POST: printed now as well.
void postLogLine(const char* fmt, ...) __attribute__((format(printf, 1, 2)));
