sephiroth74/esp32-rc-telemetry/firmware/src/keys.cpp

#include "keys.h"

#include <Arduino.h>

#include "bench_sim.h"
#include "pins.h"
#include "ui_config.h"

namespace {

// KEY_LAYOUT_DEFAULT until keysSetLayout() brings keys.layout from config.json.
ui::KeyConfig config = keyConfig();
ui::KeyReader reader(config);
ui::Gestures gestures(config);
uint16_t lastMv = 0;

}  // namespace

void keysBegin() {
  // No internal pull-up: the ladder's own 10 kΩ holds the pin, and the ADC driver disables the
  // internal one anyway. The ADC keeps its default attenuation, the one the levels in config.h were
  // measured with (docs/hardware.md).
  pinMode(PIN_KEYS, INPUT);
}

void keysTick(uint32_t nowMs) {
  lastMv = analogReadMilliVolts(PIN_KEYS);
  reader.sample(lastMv);
  gestures.update(reader.key(), nowMs);
}

void keysSetLayout(KeyLayout layout) {
  config = keyConfig(layout);
  reader = ui::KeyReader(config);
  gestures = ui::Gestures(config);
}

ui::Layout keysLayout() { return config.layout; }

bool keysNext(ui::Event& event) { return gestures.next(event); }

void keysSwallow() {
  gestures.swallow();
#ifdef BENCH_SIM
  benchSimSwallow();  // and the console's gesture, whichever the Press came from
#endif
}

uint8_t keysHoldPercent(uint32_t nowMs) { return gestures.holdPercent(nowMs); }

ui::Key keysHeld() { return reader.key(); }

uint16_t keysLastMv() { return lastMv; }
