sephiroth74/esp32-rc-telemetry/firmware/include/bench_sim.h

// The bench simulation — a build for testing without the car: `pio run -e sim -t upload`.
//
// Commands on the serial console stand in for the receiver and the keys, and print the screen, so
// that a computer can walk the device through a procedure on its own:
//   rc <steering us> <throttle us>    a receiver sending these widths at 60 Hz; 0 for an input off
//   pos neutral|left|right|throttle|brake|off
//                                     the bench car's widths (docs/hardware.md, bench session 5)
//   key ok|hold|nav|back              OK short, OK held, NAV short, NAV held: each a whole gesture,
//                                     its Press first, so one that closes a notice or wakes the
//                                     display does only that, as on the keys
//   screen                            the screen's lines as last drawn
//   usb off|on                        sleep as if no USB host were attached, or not (§4.5)
//   reset                             restarts at once, closing nothing: the car switched off
//   drive on|off                      a car lapping a 250 m stadium, its NAV-PVTs into the laps in
//                                     place of the module's (gnss_task.h); none into the log
// The simulated pulses go through the inputs' accepted windows like real ones. A sleep wakes on OK
// or after SLEEP_SIM_WAKE_S, standing in for a press (power.h). Never in the car.
#pragma once

#ifdef BENCH_SIM

#include "ui_keys.h"

void benchSimPoll();                       // reads what the console sent; every tick
bool benchSimNextEvent(ui::Event& event);  // a key waiting, if any
void benchSimSwallow();                    // keysSwallow(): the rest of the current gesture goes
bool benchSimTakeScreenRequest();          // `screen` was asked for since the last call
bool benchSimHostHidden();                 // `usb off`: the board sleeps with a host attached

#endif
