sephiroth74/esp32-rc-telemetry/(commit log)

2026-10-17 Plan the device for any RC car, with a display and a five-way switch
    The plan no longer targets one car: the device moves between cars and assumes
    only a PWM receiver and a BEC rail. The status LED gives way to the 0.96"
    SSD1306 OLED on the shared I2C bus, and the single button to a JS5208
    five-way switch on one ADC pin, with two buttons as the interim layout.
    - PLAN-ESP32.md §3 rewritten as board states, screens and key mapping;
    automatic sessions, car profiles, settings in config.json on the card,
    BLE only in Transfer mode, wake on the RC signal.
    - PLAN-UI.md: one-page overview of the UI; §3 stays authoritative.
    - ROADMAP.md: the phases broken into testable steps, menu and POST firs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
2026-10-17 Add bench tools for the display, card, GPS and key ladder
    Standalone sketches for the XIAO ESP32-S3 Sense, each answering one
    phase 1 question on real hardware:
    - oled-sd-test: OLED at 0x3C, SDMMC 1-bit at 40 MHz, long file names,
    a 256 KB write/read speed probe, a restart button, and a GPS page
    alternating with the results.
    - gps-test: the GM10 link with baud scan and MON-VER, for the XIAO
    (default) and the ESP32-WROOM devkit, with the status on the OLED.
    - keys-test: the D0 ladder readings per key, classified with the
    KEY_MV_BOUNDS of firmware/include/config.h itself.
    - lib/gm10: the NMEA/UBX decoding shared by oled-sd-test and gps-test,
    with a baud scan that never blocks.
2026-10-17 Read the key ladder and drive the display (ROADMAP 1.1, 2.1-2.4)
    - lib/ui: KeyReader (mV reading -> key, two equal readings in a row) and
    Gestures (press/up/down/back/open/hold, hold bar, the two-button
    mapping), framework-free, with 20 host tests in test/test_ui against
    the ladder levels measured on the bench.
    - include/key_config.h: the one place lib/ui's parameters come from
    config.h, shared by the device and the tests.
    - src/keys.cpp, src/ui_fsm.cpp: the ladder sampled at 100 Hz in the ui
    task on core 0; a bench screen with the live key and the events.
    - src/display.cpp, src/i2c_bus.cpp: U8g2 on a 21x8 text grid, dirty
    pages only at 5 Hz, toast, hold bar, 80 ms inversion; the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
2026-10-17 Add the menu model (ROADMAP 2.5)
    lib/ui/ui_menu: Home, the list menu of PLAN-ESP32.md §3.4 as data, the
    value editors and the two confirmation dialogs, driven by the key events.
    The menu decides nothing about the device: an entry's action comes out as
    a Command, and what it needs to know - card, fix, start line, RC signal,
    the POST's verdict on logging - goes in through MenuContext.
    - Lists wrap, so DOWN alone reaches every entry, as with the two buttons;
    each list keeps its cursor across back, and editors open on the value
    in force, so OK without a change saves nothing new.
    - Dialogs: hold OK is yes, any other key or 10 s is no.
    - 30 s without a key falls back to Home and forgets the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
2026-10-17 Render every screen on the display, with a text size setting (ROADMAP 2.6)
    - lib/ui/ui_board: the modes of PLAN-ESP32.md §3.7 above the menu -
    SESSION (markers, pages, a confirmed stop), GEOMETRY, CALIBRATION
    (six steps, DOWN skips aux, overwrite confirmed) and TRANSFER (leaving
    a USB host confirmed) - each action out as a Command with its toast.
    The menu's dialog logic moves into a shared Confirm helper.
    - lib/ui/ui_screens: a pure render of every screen of §3.4 into the grid
    of the chosen text size. Content longer than the body scrolls: lists
    keep the cursor in view, other screens turn a page per UP/DOWN, and a
    scroll bar runs down the right edge.
    - Text size is a new displ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
2026-10-17 End every list and editor with Back, and let OK go back on a leaf
    Getting out of a screen no longer needs NAV held for a second:
    - Menu, Track, Settings and Display end with a Back entry; editors end
    with a Back choice, which saves nothing.
    - On an information screen (Session, Start line, Geometry, Info, GNSS,
    Calibrate, Delete sessions, About) OK goes back and the action, where
    there is one, is a hold - Calibrate included, which used to start on OK.
    - LEFT, and NAV held with the two buttons, remain shortcuts.
    - Host tests: every list ends in Back, Back saves nothing in an editor,
    OK on a leaf returns to the entry it came from; the fit test walks every
    screen again with the new po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
2026-10-17 Make the start line and the geometry optional (PLAN-ESP32.md §7.5)
    Laps are timed without anyone setting a start line or recording a
    geometry, and both get better over time:
    - Without a start line, the gate goes at the fastest point of the first
    lap found by loop closure, saved with source "auto", and the laps
    before it are worked out again.
    - The geometry is built by the desktop app from every session at the
    track; the desktop app also places the start line accurately, and
    writes both back into the track folder for the next session.
    - start_line.json and geometry.rcg carry their source - auto, device,
    desktop - and a better one is never overwritten by a worse one.
    - Buggies leav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
2026-10-17 Upload only to the board's own USB ports
    With the board unplugged, port autodetection picked a Bluetooth headset
    and sent it the 1200-baud touch.
2026-10-17 Add tools/rc-scope, a serial-plotter scope for a receiver channel (ROADMAP 1.5)
    The ADC reads the signal wire through a 10k/10k divider about every 50 us
    and gives the level, pulse width and frame period, or the waveform, to the
    Arduino IDE's Serial Plotter. Record the Inferno's BEC at 5.90 V.
2026-10-17 Add New car and New track for cars and layouts not set up beforehand
    New car, after the profiles in Settings > Car profile, appends a Car N
    profile and lands on Calibrate; Track > New track, held, starts a fresh
    track at a known venue for a new layout. Among matching tracks the most
    recently used wins (PLAN-ESP32.md 7.1). The apps rename both. Every
    screen is tested with the longest track id, which moved the start-line
    dialog onto new lines.
2026-10-18 Record the KR-331's signal: 3.3 V logic, 16.6 ms frames
    tools/rc-scope on CH3 of the Inferno: high 3.25-3.27 V, low 0 V,
    positive pulses at 60 Hz, inside the RC_* windows of config.h. The
    scope now restarts its min and max when a signal appears, after a
    second of settling, so the rail a wire touched before and the bounces
    of plugging it in no longer show.
2026-10-18 Record the Inferno's steering widths: 1,050-1,500-1,940 us
    tools/rc-scope on CH1, per-second averages with the KT-331P's trims and
    end points as they are. Throttle on CH2 still to measure.
2026-10-18 Note that the Inferno's CH3 is the KT-331P's 3ch switch, unused
2026-10-18 Record the Inferno's throttle widths and close ROADMAP 1.5
    CH2 through a breadboard Y: neutral 1,500 us, full brake 1,005 us, full
    throttle about 1,940 us, and no telemetry from the Brainz 8 on the
    throttle wire. Every value is inside the RC_* windows of config.h.
2026-10-18 Track the VS Code recommendations of rc-graph and rc-scope
    The global gitignore drops .vscode/, so they are added by force, as in
    the other tools.
2026-10-18 Turn rc-graph into rc-live, a bar from the centre of the OLED
    The strip chart redrew the whole panel every 80 ms, a 31 ms frame, and
    lagged the stick. The bar is two pages, about 8 ms of bus, sent on its
    own at up to 50 Hz with U8g2 as in the firmware; the width, percentage,
    range and frame period are pages of their own, at lower rates.
2026-10-18 Make each RC input optional (PLAN-ESP32.md 4.3)
    Steering and throttle are logged with the GNSS data when present, each
    on its own: 0 us for an absent input, the present ones in meta.json.
    POST check 10 names the inputs present, and power-loss detection
    watches whichever is.
2026-10-18 Keep the on-device settings in NVS and apply them to the panel (ROADMAP 2.7)
    Brightness, dim delay, text size, the profile count and the active
    profile are read back at boot, range-checked, and written only when a
    command changes them. Brightness is the SSD1306 contrast; after the dim
    delay the panel drops to contrast 0, still readable. The press that
    brings it back does nothing else, as asked on the bench: swallow() now
    also drops what the gesture has queued.
2026-10-19 Resolve the upload port pattern before the 1200-baud touch
    pioarduino touched /dev/cu.usbmodem* literally, so no upload from the
    running firmware found its bootloader port since 6558b1a. A pre script
    replaces the pattern with the board's port; with no board it stays,
    and the upload fails without touching another device.
2026-10-19 Run the power-on self-test before the ui task (ROADMAP 3.1)
    lib/ui/ui_post orders the eleven checks of PLAN-ESP32.md 3.3, latches
    on a fatal one until OK is held, then retries from check 0, and lists
    what failed for 3 s, worst first. src/post runs it from setup() with
    check 0, the display, for real; the rest report -- until their steps.
    The result decides whether logging is allowed and shows the warning
    mark. displayFlush() sends ahead of a check that blocks.
2026-10-19 Show the GNSS link, fix, coordinates and track; plan geo-fences
    The GNSS screen opens on the link and its baud, the fix and satellites,
    and the track recognised, then the coordinates to six decimals. A name
    from the apps stands in for the cell id, cut to the id's 14 columns so
    every screen still fits. Tracks get an optional geo-fence drawn in the
    apps, which comes before the 300 m radius (PLAN-ESP32.md 7.1).
2026-10-19 POST checks 0-2: bus recovery, the PSRAM ring, LittleFS (ROADMAP 3.2)
    i2cBusBegin() clocks a held SDA free and ends with a STOP before Wire
    starts; check 0 reports a bus still stuck. Check 1 allocates the 256 KB
    ring of 4.4 in PSRAM, once across retries. Check 2 mounts LittleFS by
    its partitions.csv label and formats it on the first boot. A summary
    line follows the POST, since its own lines can beat the USB host.
2026-10-19 Settle DAT3 on GPIO21, keeping throttle on D2 (ROADMAP 1.2)
    tools/sd-dat3-test holds one candidate low per power-up, since a card
    picks SD or SPI mode at its first CMD0 and ignores DAT3 after that:
    GPIO3 low mounted, GPIO21 low sent the card to SPI mode. Seeed's wiki
    is wrong. pins.h holds no UNRESOLVED any more, and D1 stays spare.
2026-10-19 POST checks 3-6: mount, free space, the write probe and its speed (ROADMAP 3.3)
    src/card mounts SDMMC 1-bit at 40 MHz with DAT3 high, and on a failed
    mount asks the card why: no answer, exFAT, GPT or no FAT32. Free space
    refuses logging under 64 MB and warns under 256 MB; the 256 KB probe
    is written, read back, compared and deleted, and its write speed is
    check 6. The card's size, free space and speed reach the screens.
2026-10-19 Capture the GM10's UART and scan it for UBX frames (ROADMAP 3.4)
    tools/gps-test gains a raw dump (d) that prints six seconds of the
    UART as hex while polling NAV-PVT, NAV-SAT and MON-VER. The first
    1,691 bytes, NMEA and six UBX frames, are docs/fixtures/. lib/ubx
    returns frames whole, sync to checksum, skips the rest, and after a
    failed frame searches again from the next byte. The host tests read
    the fixture, and make the corrupted variants from it.
2026-10-19 Draw the wiring as KiCad schematics: the bench build and the car
    hardware/bench.kicad_sch is the bench as wired today, hardware/car.kicad_sch
    the planned power path, backup LiPo, 74LVC2G17 front end, JS5208 and
    IMU. Both pass KiCad's ERC, and their netlists were read net by net,
    which caught a BAT+ joined to ground that the ERC let through. PDFs and
    PNGs alongside; the generator that wrote the first version stays too.
    With DAT3 settled, this closes ROADMAP 1.6.
2026-10-19 POST check 8: find the GNSS module's baud rate (ROADMAP 3.5)
    src/gnss_link tries the rate found last, kept in NVS, then 230400,
    115200, 38400 and 9600, polling MON-VER at each, until ubx::LinkProbe
    sees a whole frame with its checksum, UBX or a $G NMEA sentence. Without
    a link logging is refused and the GNSS screen shows no fix. On the bench
    OK could not leave Transfer, which wanted NAV held: it does now. Toasts
    go to the serial log too.
2026-10-19 Refusals take the body until a key; Home says why logging is refused
    A refusal is a notice now, the reason and what to do, closed by the
    next key, which does nothing else; toasts are for confirmations only.
    When the card is missing or the POST refused logging, Home opens on
    the reason and its status line reads No logging. The screens that read
    the card do not open without it, Track Info and New track need the GNSS
    module, and every write needs a card that took the write probe. A key
    that only wakes the display leaves a notice on screen.
2026-10-19 Record the bench check of a deleted config.json (ROADMAP 3.6)
    The board wrote it back from the LittleFS copy, settings unchanged.
2026-10-20 Decode NAV-PVT and NAV-SAT in lib/ubx (ROADMAP 4.2, in progress)
    NAV-PVT comes out whole, NAV-SAT is read in place; fix3d() is the fix the
    GNSS screen and the laps trust. Host-tested on the indoor capture and on
    frames built at the documented offsets; a capture with a fix is next.
2026-10-20 Add the gnss task (ROADMAP 4.3, in progress)
    UART1 into the scanner on core 1: NAV-PVT and NAV-SAT into a live state
    for the ui, whole frames with a timestamp into a PSRAM queue of 32 while
    the logger asks, and every loss counted. It takes check 9's retry over
    from loop(). Built; the bench run is still to do.
2026-10-20 Show the live GNSS state on screen (ROADMAP 4.4, in progress)
    lib/ui gains the acquisition of §3.4: Acquiring, Fix after 3 s within
    5 m, Timeout at 90 s, a new one when the fix is lost. The ui task fills
    the facts from the gnss task: link, fix, used/seen satellites, position,
    hAcc, pDOP, speed and losses. Holding OK on the GNSS screen restarts the
    clock; the sample GNSS values are gone.
2026-10-20 Write down the .rcl format in docs/protocol.md (ROADMAP 5.1)
    A file header with a per-session nonce, then self-delimiting records
    whose CRC-32 is seeded with it, so a power cut's tail is skipped and an
    older session's bytes never pass for this one's. Eight record types; UBX
    frames whole and verbatim, RC and IMU batched per epoch.
2026-10-20 Write and read .rcl logs in lib/rcl, against a golden file (ROADMAP 5.2)
    The golden file is values in JSON and bytes in hex, the bytes written by a
    Python script from docs/protocol.md alone; lib/rcl agrees with it both
    ways. A cut at every byte, stale and zero tails, a corrupted record and a
    mangled length all keep every whole record. A length running past the end
    no longer stops the reading, so the protocol says so too.
2026-10-20 Add the logger's ring and write statistics in lib/logbuf (ROADMAP 5.3, in progress)
    Whole records go in or are dropped and counted, and come out in order
    however the writer slices them. The footer's max, p99 and slow writes
    come from a fixed histogram. Producers will append to the ring
    themselves, so a stalled write never stops them: the plan says so now.
2026-10-20 Name, recognise and number tracks and sessions in lib/geo (ROADMAP 5.4, in progress)
    docs/algorithms.md now holds the exact rules: the cell id in integers,
    the distance, an even-odd fence test exact in integers, which track a fix
    belongs to, a new track's suffix and the session numbers. A fenced track
    is recognised by its fence only, so the club next door is not taken for
    it.
2026-10-21 Start and stop sessions on their own (ROADMAP 6.4, in progress)
    lib/ui decides from speed and throttle, each counted only when known: a
    start from IDLE through Home, a refusal shown once, the stop after
    session.auto_stop_min still, and no new run after a stop by hand until
    the car has stood still. The ui task feeds it the GNSS speed; the
    throttle comes with the RC capture.
2026-10-21 Turn pulse widths into percentages by a car's calibration (ROADMAP 6.3, in progress)
    lib/rc keeps the endpoints by meaning, so a reversed channel needs no
    setting, and scales each side of neutral on its own, as ESCs travel
    further forward than back. A capture with an end that did not move, or
    both ends on one side, is not a calibration. The formulas are written
    in docs/algorithms.md for rct_core to match.
2026-10-22 Close ROADMAP 4.3 and 4.4 with the bench: 10 Hz, nothing lost, fixes cold and hot
    At a window the GM10 gave a 3D fix within 0.75 m. Cold, after two days
    unpowered, the screen's fix came in 141 s from the hold; hot, after 16 s
    unplugged, in 5 s from power-on.
2026-10-22 Close ROADMAP 4.2 with a capture of the configured GM10 holding a fix
    A second of the stream at 230400: nine NAV-PVT at 10 Hz and the periodic
    NAV-SAT, 10 satellites used of 24. The positions are moved onto the
    sample point with the checksums worked out again, so the fixture does not
    say where it was taken.
2026-10-22 Log sessions to the card: logger task, track folders, meta.json (ROADMAP 5.3-5.5, in progress)
    Producers append whole records to the PSRAM ring; the logger task writes
    it out in 32 KB chunks, fsyncs every 5 s, grows the file 4 MB ahead and
    cuts it to length on close. A session resolves its track by lib/geo's
    rules, makes session_NNN, writes meta.json and moves out of _unassigned
    when a fix comes. The gnss task's frame queue is gone: frames go into
    the ring. Built; the bench is next.
2026-10-24 Power the car through an LM2940, clamp the RC inputs with BAT43s, keep the two keys
    The car sheet's rev 2. An LM2940CT-5.0 in place of the 100 %-duty buck, and
    no diodes in the power path: a servo plug cannot swap + and -, and the
    regulator survives a reversed input on its own, so the USB is never plugged
    in while the car or a LiPo powers the board (PLAN-ESP32.md §2.7). Each RC
    input through 10 k, with a BAT43 clamp to 3V3 and 100 k to ground:
    through-hole parts in place of the 74LVC2G17 (§2.5). The bench's two keys
    go in the car too (§3.1).
    The sheet is generated again from gen_schematics.py, as it had never been
    edited in KiCad, with the UUIDs of what did not change kept; the ERC is
    cl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
2026-10-24 Start sessions on the fix and name the card's track on the screens (ROADMAP 5.3-5.5)
    - A session needs the fix, by hand or automatically: the GNSS screen's Fix,
    not a bare 3D (PLAN-ESP32.md §3.6). Home reads Acquiring until it comes, a
    hold brings "No GNSS fix yet", and the automatic start says so once.
    session.require_fix: false in config.json lifts it for the bench.
    - The screens name the card's track. sessionLookup() reads where a session
    started now would be filed: the track, its name, start line, geometry,
    sessions and next number. The ui task runs it in IDLE when the fix comes
    or goes, after 50 m, and after any session or command; without a track
    the screens say why. Tra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
2026-10-24 Make Track > New track on the card, and add Track > Choose (ROADMAP 5.4)
    New track makes its folder at the fix, the cell id with the next free
    suffix. Choose lists every track within reach of the fix, by fence or by
    radius, with its name from the apps or else its cell id, the resolved one
    marked, for where two tracks compete (PLAN-ESP32.md §7.1, decided
    2026-10-24). Either makes its track the resolved one while the fix stays
    within reach, until another is chosen or the device restarts; a session
    filed there makes it the one used most recently, which the rules then
    pick on their own.
    session.cpp loads one track at a time for both the rules and the list,
    and resolves through the track chosen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
2026-10-24 Hand the card to a USB host from Menu > Transfer (ROADMAP 9.1)
    The disk is part of the composite USB device from boot, with no medium
    until TRANSFER. Entering unmounts SD_MMC and hands the card's sectors to
    the host through USBMSC, so that the firmware and the host never both own
    the FAT volume; leaving takes the medium away and mounts the card again.
    A host that ejected the disk has let go of it: the display says so and
    leaving asks nothing, where otherwise it asks first (PLAN-ESP32.md §7.3).
    A card that will not go ends TRANSFER with a notice.
    Seen on the bench against macOS (docs/hardware.md, bench session 4): the
    disk mounted as TELEMETRY, read, ejected and left, and the confirmation
    w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
2026-10-24 Stabilise the LM2940 with a low-ESR electrolytic, make the IMU optional
    - C3, the LM2940's output capacitor, is a Panasonic EEU-FR1C101: 100 uF
    16 V at 0.3 ohm, inside the 0.1-1 ohm the regulator needs. The small
    dipped tantalums first drawn run 1.3-2 ohm, too high (PLAN-ESP32.md
    §2.7); C1 is its 470 uF sibling, EEU-FR1C471.
    - The IMU is optional (§2.6): drawn crossed out in car.kicad_sch (DNP),
    dashed in wiring-car. It costs no pin, sharing the display's I2C bus at
    0x6A and read through its FIFO; mounting it rigid on the chassis is the
    harder part.
    - wiring-power-ldo goes: wiring-car draws the LM2940's pins, and its
    checklist joins the car drawing's warnings.
    Co-Authored-By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
2026-10-24 Capture the receiver's steering and throttle, and log them (ROADMAP 6.2)
    src/rc_capture.cpp times both inputs on one MCPWM capture timer, edges
    stamped in hardware, as tools/rc-live did for one channel. Each pulse is
    checked against its width and frame windows, rejects are counted per
    input, and an input is present once a pulse passes (PLAN-ESP32.md §4.3).
    A 50 Hz sampler logs RC records, five to an epoch, while a session is
    open; the footer takes the session's rejects, meta.json the inputs
    present, and POST check 10 names them.
    The screens show the live widths: Calibrate's, and the session's inputs
    page in µs until a calibration (step 6.3). With two buttons, Calibrate's
    hint says what ho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
2026-10-24 Re-enumerate on entering Transfer, so that macOS mounts the disk (ROADMAP 9.1)
    In a later Transfer the disk stayed without its medium on the Mac: the
    host listed the mass-storage interface and its logical unit, and never
    asked again for a medium that arrived after enumeration. The core's
    USBMSC gives no way to report the change, so the device now leaves the
    bus for 300 ms on entering and comes back; the Mac finds the medium and
    mounts the disk within seconds (docs/hardware.md, bench session 4). The
    serial port drops for that moment.
2026-10-24 Keep a calibration per car profile, and simulate the bench car (ROADMAP 6.3)
    src/calibration.cpp keeps one calibration a profile in NVS, loads the
    active profile's once the ui task knows it and on a change of profile,
    and clears it for New car. A calibrated input accepts its own ends,
    widened by RC_WINDOW_MARGIN_US; one left out keeps the 800-2200 µs.
    meta.json's car_profile.calibration gives each input's endpoints, null
    for one left out, and null altogether for a profile never calibrated.
    Calibrate's summary shows the endpoints captured and will not save a
    capture that is no calibration: it names the input and why, and only
    goes back (lib/rc's problem(), docs/algorithms.md). The session's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
2026-10-24 Set session.require_fix on the device, from Settings > Require fix
    The bench turns the fix off and the track wants it on, and editing
    config.json by hand for each was one step too many. Settings > Require
    fix is an editor like the display's, off and on, opening on the value in
    force, which also shows beside it in the Settings list. The change takes
    effect at once, Home's Acquiring and the start's refusal with it, and
    goes to both copies of config.json as the display settings do; settings
    fill it into the menu with the rest (PLAN-ESP32.md §3.4, §3.6, §3.8).
    The bench simulation now sends each key as the keys do, a Press first,
    and keysSwallow() drops the rest of its gesture: a refusal's n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
2026-10-25 Close at boot a session the car's switch cut, and sleep from IDLE (ROADMAP 6.5)
    There is no backup battery (decided 2026-10-25): the device goes off
    with the car within a millisecond or so, so a session is ended by hand,
    or by the automatic stop, before the switch. The 1S LiPo on BAT+/BAT-
    leaves car.kicad_sch (rev 3; BT1 out, the pads unconnected, ERC clean,
    only those nets changed) and the wiring drawing, and the status bar its
    LiPo mark (PLAN-ESP32.md §2.7, §4.5).
    A session the switch cuts is closed at the next boot: sessionBegin()
    names it in NVS and sessionEnd() clears it, and sessionRecover() cuts
    its .rcl after the last whole record and gives meta.json
    `close: unclosed`, a line in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
2026-10-25 Find laps with a start line, and the line without one (ROADMAP 8.1-8.3)
    docs/algorithms.md gains "Laps": the epochs that count (gnssFixOK and
    3D), the local plane, the gate, and a crossing - forwards, the fixes
    1000 ms apart at most, within the gate's width, interpolated to the ms,
    5 s after the last one counted - a lap's distance, and its flags
    against the median, cut under 85 %, off over 130 %.
    Without a start line (decided 2026-10-25, PLAN-ESP32.md §7.5): the
    first loop the trace closes gives a provisional gate, which cuts the
    trace into laps; the first two consecutive laps that agree - the
    shorter at least 90 % of the longer, 95 % of each within 10 m of the
    other's path - give the line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
2026-10-26 Time laps on the device, and record the start line on the move (ROADMAP 8.4, 8.5)
    Every NAV-PVT now reaches the ui task through a queue of its own
    (gnss_task.h), and src/lap_timer.cpp times the open session's laps with
    lib/geo: the track's start line, or the search for one over a 10-minute
    trace in PSRAM, the line then saved for the track with source `auto`
    and the laps so far found again. Each crossing is a Lap record with the
    flags its lap has then; the session's page and Home show the count,
    the last, the best of the laps not flagged and the delta, and a lap
    completed is a toast. Home's line is now the best lap.
    start_line.json holds the whole gate - position, heading, width,
    source (ses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
2026-10-26 Lay out the car's perfboard hole by hole, and start its enclosure
    gen_perfboard.py places the car build on the EPLZON 50.8 x 38.1 mm
    solderable breadboard and draws it, in Italian, as perfboard-car.svg:
    the parts from above, the copper-side wires, the wires up to the
    lid's parts and the assembly notes. It checks the layout before
    drawing - every lead in a free hole, no two bodies in the same space,
    the lid's parts included, one net per strip, and the strips joined
    into exactly car.kicad_sch's nets - and stops at the first problem.
    The receiver now plugs into two 2-pole JST-PH side-entry headers (the
    kit at hand, pre-crimped leads), J1 for BEC+ and GND on B12/B13 and J2
    for CH1 and CH2 on B9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
2026-10-26 Finish the enclosure for a first print: hatch, flat lid, clamps, STLs
    The left wall gains a 14.2 x 11.4 mm opening over the USB-C port and
    the microSD card, closed by a hatch that slides in 45-degree dovetail
    rails and snaps shut on a sprung tongue; the card's slot is friction,
    so nothing has to hold it in.
    The lid is now flat, 4.4 mm thick, so it prints upside down with no
    supports: a raised bezel round the display had left no face to put on
    the bed. The keys' T-shaped pads sit flush in pockets, out of the way
    of a crash, and the display's four screws go into brass inserts set
    from the top. A cup hanging from the lid holds C1 from above, and a
    bar sprung against the GM10's shield, resting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
2026-10-26 Print the enclosure without overhangs, and hold its hatch for real
    Two problems came up on the way to the first print. Upside down, the
    lid grew ledges where its posts widen round the brass inserts. And the
    hatch did not stay on: its 45-degree rails were the wrong way round,
    the channel widening outwards, so they held it only up and down, and
    its snap even pushed it off. A horizontal dovetail that holds needs a
    lip hanging down from the upper rail, which cannot print on the
    upright tub.
    The hatch now slides down from above, beside the lid, into two
    vertical dovetail guides either side of the opening, which print
    upright as they stand, and rests on a 45-degree ledge. A tongue above
    the openi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
2026-10-26 gitignore + kicad mods
2026-10-26 Make each key one captive piece that caps its switch
    The keys were a stem held under the lid by a flange, with a wider pad
    glued on top. The pad could come off with its glue, and three guides
    in parallel (the stem, a pin and the pad's pocket), pushed up to
    7.5 mm away from the switch, could wedge a key down.
    Each key is now a single printed piece in a hole through the lid,
    guided by the lid's whole 4.4 mm and kept in by a flange under it, so
    it leaves only when the box is opened. The keys sit closer over their
    switches (7.5 x 8.3 mm, 1.5 mm apart), keeping the push within the
    reach a guide that long allows without jamming; the GM10's frame
    under the lid sets their length. Underneath, a cap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
2026-10-26 Add a step-by-step assembly guide for the car device
    assembly-car.pdf takes the build from the printed parts and loose
    components to the box on the car, in Italian: the brass inserts, the
    perfboard soldered in a buildable order, the lid's parts, the wires
    between lid and board, closing the box, the receiver's wiring and the
    first start.
    Each soldering step has its own drawing, drawn from gen_perfboard.py's
    data so that it follows the layout that script checks: the step's
    parts in colour, the ones already fitted in grey, and every hole
    named with what it is for. The power section goes on first and is
    tried at 5 V before the XIAO, as wiring-car already advised. At
    closing, the board hinges on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
2026-10-27 Model C1 and C3 as the Panasonic parts ordered, and fit C1's collar
    C1 and C3 are now Panasonic's own models of the parts on order, the
    EEU-FR1C471 and the EEU-FR1C101, in place of the placeholders, which
    stay hidden. The models are drawn at the largest size the datasheet
    allows, Ø8.5 x 13 and Ø5.5 x 12.5 mm against 8 x 11.5 and 5 x 11
    nominal, so the checks hold whatever the cans measure.
    C3 fits as it was, 0.84 mm under the GM10. C1 did not: at its largest
    it touched both its collar and J1, and at its nominal height the
    collar held it by 1 mm only. Its hole is now the parameter c1_d, 8.7
    mm, to set to the real can plus 0.3 mm before printing the lid. The
    collar starts 3.5 mm lower and h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
2026-10-27 Cover the display with a hinged flap, and thicken the GM10 clamp
    The display sat open in the lid, where a crash or a roll-over could
    reach its glass. A printed flap now covers it: hinged at the back on
    two lugs of the lid, turning on a 26 mm pin of 1.75 mm filament, with
    a plug that fills the window and a front tab whose barb snaps into a
    groove in the lid's front edge. The display's inserts now stop on the
    floor of their holes, just below the top, so the flap closes flat.
    The GM10's clamp bar was 0.6 mm thick, three layers, too thin to
    trust. It is now 1.2 mm, grown downwards so that its face on the
    module stays where it was; the front post and its slot follow, and
    the clamp's screw become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
